zhaowei0566/mAEWing1/Design/FEM/FEM v5.2/Matlab files/README.txt

v2 has some changes in the nodal coordinates for control flaps in inner wing body flap and outer wing trailing-edge control surfaces
Mode results and nodal coordinates along EA are same.
