zhaowei0566/mAEWing1/Design/CAD/mAEWing1 - Mass Properties.xlsx

Sheet: Skoll - Tracking
 |  |  | Position of Body CG (inch) |  |  | Inertia about Body CG (Kg-m^2)
 |  | Mass (g) | xCG | yCG | zCG | Ixx | Iyy | Izz | Notes
2015-06-06 | Airframe (CB1 + WS1) | 6269.81 | -23.73 | 0.00 | -0.49 | 3.098 | 0.528 | 3.315 | Summary Test Results
2015-06-06 | Removed Ballast | -109.34 | -4.62 | 0.00 | -0.90 | 0 | 0 | 0 | Assume negligible body inertia
 | Airframe | 6160.47 | -24.07 | 0.00 | -0.48 | 3.098 | 0.502 | 3.288
2015-06-06 | Removed Temporary Avionics Cover | -104.4 | -9.09 | 0.00 | -1.97 | 0.000318 | 0.0005964 | 0.0008816
 | Airframe | 6056.07 | -24.32 | 0.00 | -0.46 | 3.097 | 0.486 | 3.272
2015-06-11 | Added Collet + Yoke + Propeller | 47 | -33.99 | 0.00 | -1.24 | 0 | 0 | 0 | Assume negligible body inertia
 | Airframe | 6103.07 | -24.40 | 0.00 | -0.46 | 3.097 | 0.488 | 3.275
2015-06-11 | Added Avionics Cover | 58 | -9.09 | 0.00 | -1.97 | 0.0001766666667 | 0.0003313333333 | 0.0004897777778 | Scale Body Inertia from previous
 | Airframe | 6161.07 | -24.25 | 0.00 | -0.48 | 3.098 | 0.497 | 3.284
2015-06-15 | Added Ballast | 165 | -4.62 | 0.00 | -0.90 | 0 | 0 | 0 | Assume negligible body inertia
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
