zhaowei0566/mAEWing1/Design/CAD/mAEWing1 - BOM.xlsx

Sheet: Parts List
System | WBS | Type | Rev | Part Num | BOM Level | 1 | 2 | 3 | 4 | 5 | 6 | Part Name | Part Description | Qty | Material | Notes
mAE1 | 1000 | A | A | mAE1_A1000_A | 1 | X |  |  |  |  |  | Aircraft |  | 1 | N/A
mAE1 | 1050 | P | A | mAE1_P1050_A | 2 |  | X |  |  |  |  | body flap |  | 2 | E-glass / EPS 1.5#
mAE1 | 8001 | P | A | mAE1_P8001_A | 2 |  | X |  |  |  |  | Wing Attach Bushing | Bushing for #10-32 bolts in wing attach | 24 | ABS Plastic | Not depicted in CAD model
mAE1 | 2100 | A | A | mAE1_A2100_A | 2 |  | X |  |  |  |  | Centerbody Assembly |  | 1 | N/A
mAE1 | 2101 | P | A | mAE1_P2101_A | 3 |  |  | X |  |  |  | inboard rib |  | 2 | 1/8" Birch Ply
mAE1 | 2102 | P | A | mAE1_P2102_A | 3 |  |  | X |  |  |  | inboard keel attachment |  | 2 | 1/8" Birch Ply
mAE1 | 2103 | P | A | mAE1_P2103_A | 3 |  |  | X |  |  |  | left center body |  | 1 | E-glass / EPS 1.5#
mAE1 | 2104 | P | A | mAE1_P2104_A | 3 |  |  | X |  |  |  | right center body |  | 1 | E-glass / EPS 1.5#
mAE1 | 2105 | P | A | mAE1_P2105_A | 3 |  |  | X |  |  |  | center body attach |  | 2 | 1/4" carbon/foam panel
mAE1 | 2106 | P | A | mAE1_P2106_A | 3 |  |  | X |  |  |  | spar front top left |  | 1 | 0.4" Carbon/foam panel
mAE1 | 2107 | P | A | mAE1_P2107_A | 3 |  |  | X |  |  |  | spar rear left |  | 1 | 0.4" Carbon/foam panel
mAE1 | 2108 | P | A | mAE1_P2108_A | 3 |  |  | X |  |  |  | spar front bottom left |  | 1 | 0.4" Carbon/foam panel
mAE1 | 2109 | P | A | mAE1_P2109_A | 3 |  |  | X |  |  |  | spar front bottom right |  | 1 | 0.4" Carbon/foam panel
mAE1 | 2110 | P | A | mAE1_P2110_A | 3 |  |  | X |  |  |  | spar front top right |  | 1 | 0.4" Carbon/foam panel
mAE1 | 2111 | P | A | mAE1_P2111_A | 3 |  |  | X |  |  |  | spar rear right |  | 1 | 0.4" Carbon/foam panel
mAE1 | 2112 | P | A | mAE1_P2112_A | 3 |  |  | X |  |  |  | keel |  | 2 | 1/8" Birch Ply
mAE1 | 2113 | P | A | mAE1_P2113_A | 3 |  |  | X |  |  |  | tail hard point |  | 1 | 1/8" Birch Ply
mAE1 | 2150 | A | A | mAE1_A2150_A | 3 |  |  | X |  |  |  | motor mount assembly |  | 1 | N/A
mAE1 | 2151 | P | A | mAE1_P2151_A | 4 |  |  |  | X |  |  | motor mount |  | 1
mAE1 | 2152 | P | A | mAE1_P2152_A | 4 |  |  |  | X |  |  | motor mount cover |  | 1
dum |  |  |  | dum__ | 3 |  |  | X |  |  |  | motor - dummy |  | 1 | N/A | See Flight Systems
mAE1 | 2160 | A | A | mAE1_A2160_A | 3 |  |  | X |  |  |  | Airdata Assembly |  | 1 | N/A
mAE1 | 2161 | P | A | mAE1_P2161_A | 4 |  |  |  | X |  |  | airdata boom |  | 1 | Carbon tube
dum |  |  |  | dum__ | 4 |  |  |  | X |  |  | pitot-static probe - dummy |  | 1 | N/A | See Flight Systems
dum |  |  |  | dum__ | 3 |  |  | X |  |  |  | servo - dummy |  | 2 | N/A | See Flight Systems
dum |  |  |  | dum__ | 3 |  |  | X |  |  |  | servo tray - dummy |  | 2 | N/A | See Flight Systems
mAE1 | 2170 | P | A | mAE1_P2170_A | 3 |  |  | X |  |  |  | flight computer tray |  | 1 | 1/8" Birch Ply
dum |  |  |  | dum__ | 3 |  |  | X |  |  |  | flight computer - dummy |  | 1 | N/A | See Flight Systems
mAE1 | 2171 | P | A | mAE1_P2171_A | 3 |  |  | X |  |  |  | battery tray |  | 1 | 1/8" Birch Ply
dum |  |  |  | dum__ | 3 |  |  | X |  |  |  | Propulsion Battery - dummy |  | 1 | N/A | See Flight Systems
dum |  |  |  | dum__ | 3 |  |  | X |  |  |  | Avionics Battery - dummy |  | 1 | N/A | See Flight Systems
mAE1 | 2180 | A | A | mAE1_A2180_A | 3 |  |  | X |  |  |  | centerbody servo bracket assembly |  | 2 | N/A
mAE1 | 2181 | P | A | mAE1_P2181_A | 4 |  |  |  | X |  |  | servo bracket-servo attach |  | 1 | 1/8" Birch Ply
mAE1 | 2182 | P | A | mAE1_P2182_A | 4 |  |  |  | X |  |  | servo bracket-spar attach |  | 1 | 1/8" Birch Ply
dum |  |  |  | dum__ | 3 |  |  | X |  |  |  | servo - dummy | Futaba S9254, Use JR Servo Tray to mount | 2 | N/A | See Flight Systems
dum |  |  |  | dum__ | 3 |  |  | X |  |  |  | accel - dummy |  | 2 | N/A | See Flight Systems
mAE1 | 2191 | P | A | mAE1_P2191_A | 3 |  |  | X |  |  |  | camera lens mount | lens mount for mobius action cam lens | 1 | ABS
dum |  |  |  | dum__ | 3 |  |  | X |  |  |  | camera - dummy |  | 1 | N/A | See Flight Systems
dum |  |  |  | dum__ | 3 |  |  | X |  |  |  | camera imager and lens |  | 1 | N/A | See Flight Systems
mAE1 | 2200 | A | A | mAE1_A2200_A | 2 |  | X |  |  |  |  | Left Wing Assembly |  | 1 | N/A
mAE1 | 2210 | A | A | mAE1_A2210_A | 3 |  |  | X |  |  |  | wing spar |  | 1 | 0.4" Carbon/foam beam
mAE1 | 2211 | P | A | mAE1_P2211_A | 4 |  |  |  | X |  |  | wing spar foam |  | 1 | XPS Foam 2.3#
mAE1 | 2212 | P | A | mAE1_P2212_A | 4 |  |  |  | X |  |  | wing spar skin |  | 1 | Carbon [45,0,0]
mAE1 | 2213 | P | A | mAE1_P2213_A | 3 |  |  | X |  |  |  | top front left reinforcement |  | 1 | 0.4" Carbon/foam panel
mAE1 | 2214 | P | A | mAE1_P2214_A | 3 |  |  | X |  |  |  | top back left reinforcement |  | 1 | 0.4" Carbon/foam panel
mAE1 | 2215 | P | A | mAE1_P2215_A | 3 |  |  | X |  |  |  | bottom front left reinforcement |  | 1 | 0.4" Carbon/foam panel
mAE1 | 2216 | P | A | mAE1_P2216_A | 3 |  |  | X |  |  |  | bottom back left reinforcement |  | 1 | 0.4" Carbon/foam panel
mAE1 | 2220 | P | A | mAE1_P2220_A | 3 |  |  | X |  |  |  | left inboard wing |  | 1 | E-glass / EPS 1.5#
mAE1 | 2221 | P | A | mAE1_P2221_A | 3 |  |  | X |  |  |  | left outboard wing |  | 1 | E-glass / EPS 1.5#
mAE1 | 2222 | P | A | mAE1_P2222_A | 3 |  |  | X |  |  |  | left wing washout |  | 1 | E-glass / EPS 1.5#
mAE1 | 2230 | P | A | mAE1_P2230_A | 3 |  |  | X |  |  |  | wing attach rib |  | 1 | 1/4" carbon/foam panel
mAE1 | 2240 | P | A | mAE1_P2240_A | 3 |  |  | X |  |  |  | winglet attach |  | 1 | 1/4" carbon/foam panel
mAE1 | 2250 | P | A | mAE1_P2250_A | 3 |  |  | X |  |  |  | winglet |  | 1 | 1/4" carbon/foam panel
mAE1 | 2260 | P | A | mAE1_P2260_A | 3 |  |  | X |  |  |  | control surface |  | 3 | E-glass / EPS 1.5# | Make from Wing
dum |  |  |  | dum__ | 3 |  |  | X |  |  |  | servo - dummy | Futaba S9254, Use JR Servo Tray to mount | 3 | N/A | See Flight Systems
dum |  |  |  | dum__ | 3 |  |  | X |  |  |  | accel - dummy |  | 2 | N/A | See Flight Systems
mAE1 | 2300 | A | A | mAE1_A2300_A | 2 |  | X |  |  |  |  | Right Wing Assembly |  | 1 | N/A
mAE1 | 2310 | A | A | mAE1_A2310_A | 3 |  |  | X |  |  |  | wing spar |  | 1 | 0.4" Carbon/foam beam
mAE1 | 2311 | P | A | mAE1_P2311_A | 4 |  |  |  | X |  |  | wing spar foam |  | 1 | XPS Foam 2.3#
mAE1 | 2312 | P | A | mAE1_P2312_A | 4 |  |  |  | X |  |  | wing spar skin |  | 1 | Carbon [45,0,0]
mAE1 | 2313 | P | A | mAE1_P2313_A | 3 |  |  | X |  |  |  | top front right reinforcement |  | 1 | 0.4" Carbon/foam panel
mAE1 | 2314 | P | A | mAE1_P2314_A | 3 |  |  | X |  |  |  | top back right reinforcement |  | 1 | 0.4" Carbon/foam panel
mAE1 | 2315 | P | A | mAE1_P2315_A | 3 |  |  | X |  |  |  | bottom front right reinforcement |  | 1 | 0.4" Carbon/foam panel
mAE1 | 2316 | P | A | mAE1_P2316_A | 3 |  |  | X |  |  |  | bottom back right reinforcement |  | 1 | 0.4" Carbon/foam panel
mAE1 | 2320 | P | A | mAE1_P2320_A | 3 |  |  | X |  |  |  | right inboard wing |  | 1 | E-glass / EPS 1.5#
mAE1 | 2321 | P | A | mAE1_P2321_A | 3 |  |  | X |  |  |  | right outboard wing |  | 1 | E-glass / EPS 1.5#
mAE1 | 2322 | P | A | mAE1_P2322_A | 3 |  |  | X |  |  |  | right wing washout |  | 1 | E-glass / EPS 1.5#
mAE1 | 2330 | P | A | mAE1_P2330_A | 3 |  |  | X |  |  |  | wing attach rib |  | 1 | 1/4" carbon/foam panel
mAE1 | 2340 | P | A | mAE1_P2340_A | 3 |  |  | X |  |  |  | winglet attach |  | 1 | 1/4" carbon/foam panel
mAE1 | 2350 | P | A | mAE1_P2350_A | 3 |  |  | X |  |  |  | winglet |  | 1 | 1/4" carbon/foam panel
mAE1 | 2360 | P | A | mAE1_P2360_A | 3 |  |  | X |  |  |  | control surface |  | 3 | E-glass / EPS 1.5# | Make from Wing
dum |  |  |  | dum__ | 3 |  |  | X |  |  |  | servo - dummy | Futaba S9254, Use JR Servo Tray to mount | 3 | N/A | See Flight Systems
dum |  |  |  | dum__ | 3 |  |  | X |  |  |  | accel - dummy |  | 2 | N/A | See Flight Systems
Definitions
System | Aircraft Type designation (mAE1 - MiniMUTT Type, dum - dummy/COTS type, mAE2, xAE3)
WBS | Work Breakdown Structure Level
Type | Part Type (A-Assembly, P-Part, S-Standard, T-Tool)
Rev | Revision Level (new part = A)
Part Num | Generated Part Number
BOM Level | Hierarchy level
Part Name | Part Name
Part Description | Part Description
Qty | Quatity reuired to the next highest level
Material | Material Description
Notes | Part Notes

Sheet: Flight Systems and Standards
Category | System | Description | Manufacturer | Model | Qty | Unit | Notes | Cost - Unit ($) | Cost - Total ($) | Cost Quality | Weight - Unit (g) | Weight - Total (g) | Weight Quality | Size - Unit (xx) | Product Link | Avionics Bay | Battery Bay | Motor
Flight Systems | Flight Cntrl Comp | Flight Computer Assembly | UMN | Goldy | 1 | each |  | $2300.00 | $2300.00 | Estimated | 250 | 250 | Actual |  |  | 1
Flight Systems | Flight Cntrl Comp | Flight Computer | Phytec | 5200 Tiny | [1] | each |  | $140.00
Flight Systems | Flight Cntrl Comp | Daughterboard | UMN | UMN | [1] | each |  | $260.00
Flight Systems | Flight Cntrl Comp | IMU | Analog Devices | ADIS16405 | [1] | each |  | $800.00
Flight Systems | Flight Cntrl Comp | GPS Card | Hemisphere | Crescent | [1] | each |  | $300.00
Flight Systems | Flight Cntrl Comp | TM | FreeWave | MM2 900 MHz | [1] | each |  | $700.00
Flight Systems | Flight Cntrl Comp | RX Mux | AcroName | RX Mux | [1] | each |  | $80.00
Flight Systems | Flight Cntrl Comp | PWM | Arduino | Pro Mini | [1] | each |  | $20.00
Flight Systems | Flight Cntrl Comp | GPS Antenna | GPS Outfitters | Titan III | 1 | each | With shortened coax cable, removed cover | $59.99 | $59.99 | Actual | 60 | 60 | Actual | 2"L x 1.75W x 0.56"H | http://www.amazon.com/GPS-Outfitters-Titan-Universal-Antenna/dp/B0000ATIUG | 1
Flight Systems | Telemetry | TM Antennae |  |  | 1 | each |  | $5.00 | $5.00 | Estimated | 10 | 10 | Estimated |  |  | 1
Flight Systems | Telemetry | TM Coax Cable |  |  | 1 | each |  | $5.00 | $5.00 | Estimated | 3 | 3 | Estimated |  |  | 1
Flight Systems | RC Equipment | Receiver | Spektrum | AR8000 | 1 | each |  | $116.99 | $116.99 | Actual | 10 | 10 | Actual | 34.3 X 32.3 X 11.4 mm | http://www.horizonhobby.com/ar8000-8-channel-dsmx-receiver-spmar8000 | 1
Flight Systems | RC Equipment | Systems Battery | Turnigy | 800mAh 3S 1C Lipo Pack | 1 | each |  | $7.64 | $7.64 | Actual | 78 | 78 | Actual |  | http://www.hobbyking.com/hobbyking/store/__9173__Turnigy_800mAh_3S_20C_Lipo_Pack.html | 1
Flight Systems | RC Equipment | BEC | Castel Creations | CC BEC Pro | 2 | each | Modify with 18 Awg wire on output | $38.30 | $76.60 | Actual | 34 | 68 | Actual |  | http://www3.towerhobbies.com/cgi-bin/wti0001p?&I=LXYCA6&P=ML |  | 2
Flight Systems | Centerbody Actuation | Servo | Futaba | S9254 | 2 | each |  | $109.99 | $219.98 | Actual | 51 | 102 | Actual |  | http://www3.towerhobbies.com/cgi-bin/wti0001p?&I=LXFZP1
Flight Systems | Centerbody Actuation | Servo - Alternate | BK | DS-5001HV | 0 | each |  | $90.00 | $0.00 | Actual | 50 | 0 | Estimate |  | http://www.helidirect.com/bk-mini-cyclic-hv-servo-coreless-motor-speed-0-03s-torque-10-6kg-blue.html
Flight Systems | Centerbody Actuation | Servo - Alternate | Xpert | MM-3301-HV | 0 | each |  | $129.90 | $0.00 | Actual | 39 | 0 | Estimate |  | http://www.helidirect.com/xpert-mm-3301-hv-full-aluminum-mini-size-servo.html
Flight Systems | Centerbody Actuation | Servo Tray | JR | JRPA244 | 2 | each |  | $2.50 | $5.00 | Actual | 5 | 10 | Actual |  | http://www.horizonhobby.com/servo-tray-aileron-jrpa244
Flight Systems | Centerbody Actuation | Servo Arm | SECraft | SE0063 | 2 | each | Servo Arm 1" #4-40 | $15.00 | $30.00 | Actual | 1 | 2 | Estimate |  | http://www.espritmodel.com/aluminum-servo-arm-half-v3-futaba.aspx
Flight Systems | Centerbody Actuation | Servo Arm | SECraft | SWBFUTABA1 | 0 | each | Alternate - Servo Arm 1" #4-40 | $9.50 | $0.00 | Actual | 1 | 6 | Estimate |  | http://www.espritmodel.com/swb-doubleloc-servo-arms-futaba.aspx
Flight Systems | Centerbody Actuation | Servo Pushrod | SECraft | SE202 | 2 | each | 2.5" trunbuckle pushrod #4-40 | $3.75 | $7.50 | Actual | 0 | 0 | Estimate |  | http://www.espritmodel.com/pushrod-turnbuckle-aluminum-secraft-440-2.aspx
Flight Systems | Centerbody Actuation | Ball link | Dubro | DUB2318 | 4 | each | 12/pkg - 2 per surface | $2.33 | $9.33 | Actual | 0 | 0 | Estimate |  | http://www3.towerhobbies.com/cgi-bin/wti0001p?&I=LXJGU0
Flight Systems | Centerbody Actuation | Ball link - Alternate | SECraft | SC-BSBLV1-4-BK | 0 | each | 10/pkg - 1 per surface | $0.88 | $0.00 | Actual | 0 | 0 | Estimate |  | http://www.gator-rc.com/secraft-ball-link-4-40-qty-10
Flight Systems | Centerbody Actuation | Surface Horn | Robart | 326 5/16" ball link control horn | 4 | each | 2/pkg - 2 per surface | $1.84 | $7.38 | Actual | 1 | 4 | Estimate |  | http://www3.towerhobbies.com/cgi-bin/wti0001p?I=LXET41&P=FB&Q=1
Flight Systems | Centerbody Actuation | Surface Horn - Alternate | F3A Unlimited | FH5012 | 0 | each | 2/pkg - 1 per surface | $4.00 | $0.00 | Actual | 1 | 0 | Estimate |  | http://www.gator-rc.com/ball-bearing-clevis-w-flag-attachment-for-control-horn-2-pack-fh5013
Flight Systems | Centerbody Actuation | Hinges | Dubro | #257 - Nylon Hinge Heavy Duty w/cotter | 6 | each | 15/pkg - 3 per surface | $0.45 | $2.68 | Actual | 0 | 0 | Estimate |  | http://www3.towerhobbies.com/cgi-bin/wti0001p?&I=LXD944&P=M
Flight Systems | Wing Actuation | Servo | Futaba | S9254 | 6 | each |  | $109.99 | $659.94 | Actual | 51 | 306 | Actual |  | http://www3.towerhobbies.com/cgi-bin/wti0001p?&I=LXFZP1
Flight Systems | Wing Actuation | Servo - Alternate | BK | DS-5001HV | 0 | each |  | $90.00 | $0.00 | Actual | 50 | 0 | Estimate |  | http://www.helidirect.com/bk-mini-cyclic-hv-servo-coreless-motor-speed-0-03s-torque-10-6kg-blue.html
Flight Systems | Centerbody Actuation | Servo - Alternate | Xpert | MM-3301-HV | 0 | each |  | $129.90 | $0.00 | Actual | 39 | 0 | Estimate |  | http://www.helidirect.com/xpert-mm-3301-hv-full-aluminum-mini-size-servo.html
Flight Systems | Wing Actuation | Servo Tray | JR | JRPA244 | 6 | each |  | $2.50 | $15.00 | Actual | 5 | 30 | Actual |  | http://www.horizonhobby.com/servo-tray-aileron-jrpa244
Flight Systems | Wing Actuation | Servo Arm | SECraft | SE0063 | 6 | each | Servo Arm 1" #4-40 | $15.00 | $90.00 | Actual | 1 | 6 | Estimate |  | http://www.espritmodel.com/aluminum-servo-arm-half-v3-futaba.aspx
Flight Systems | Wing Actuation | Servo Arm | SECraft | SWBFUTABA1 | 0 | each | Alternate - Servo Arm 1" #4-40 | $9.50 | $0.00 | Actual | 1 | 6 | Estimate |  | http://www.espritmodel.com/swb-doubleloc-servo-arms-futaba.aspx
Flight Systems | Wing Actuation | Servo Pushrod | SECraft | SE202 | 6 | each | 2.5" trunbuckle pushrod #4-40 | $3.75 | $22.50 | Actual | 0 | 0 | Estimate |  | http://www.espritmodel.com/pushrod-turnbuckle-aluminum-secraft-440-2.aspx
Flight Systems | Wing Actuation | Ball link | Dubro | DUB2318 | 12 | each | 12/pkg - 2 per surface | $2.33 | $28.00 | Actual | 0 | 0 | Estimate |  | http://www3.towerhobbies.com/cgi-bin/wti0001p?&I=LXJGU0
Flight Systems | Centerbody Actuation | Ball link - Alternate | SECraft | SC-BSBLV1-4-BK | 0 | each | 10/pkg - 1 per surface | $0.88 | $0.00 | Actual | 0 | 0 | Estimate |  | http://www.gator-rc.com/secraft-ball-link-4-40-qty-10
Flight Systems | Wing Actuation | Surface Horn | Robart | 326 5/16" ball link control horn | 12 | each | 2/pkg - 2 per surface | $1.84 | $22.14 | Actual | 1 | 12 | Estimate |  | http://www3.towerhobbies.com/cgi-bin/wti0001p?I=LXET41&P=FB&Q=1
Flight Systems | Wing Actuation | Surface Horn - Alternate | F3A Unlimited | FH5012 | 0 | each | 2/pkg - 1 per surface | $4.00 | $0.00 | Actual | 1 | 0 | Estimate |  | http://www.gator-rc.com/ball-bearing-clevis-w-flag-attachment-for-control-horn-2-pack-fh5013
Flight Systems | Wing Actuation | Hinges | Dubro | #117- Nylon Hinge Standard | 18 | each | 15/pkg - 3 per surface | $0.33 | $5.99 | Actual | 0 | 0 | Estimate |  | http://www3.towerhobbies.com/cgi-bin/wti0001p?&I=LXD941&P=ML
Flight Systems | Wing Actuation | Servo Reverser | Expert | EXRA320 | 1 | each | Comes with Y-Harness, remove | $8.50 | $8.50 | Actual | 10 | 10 | Estimate |  | http://www.horizonhobby.com/y-harness-6-inch-reverser-standard-exra320
Flight Systems | Propulsion System | Motor | E-Flite | Power 52 | 1 | each |  | $109.99 | $109.99 | Actual | 357 | 357 | Actual |  | http://www.horizonhobby.com/airplanes/motors/power-52-brushless-outrunner-motor--590kv-eflm4052a |  |  | 1
Flight Systems | Propulsion System | Speed Control | Castle Creation | Phoenix Edge Lite 75 | 1 | each |  | $102.00 | $102.00 | Actual | 85 | 85 | Actual |  | http://www.horizonhobby.com/phoenix-edge-lite-75--34v-75-amp-esc-w--5-amp-bec-cse010011200 |  |  | 1
Flight Systems | Propulsion System | Propulsion Battery | Thunder Power | TP3300-3SPP45 | 2 | each | 3300mAh 3-Cell | $69.00 | $138.00 | Actual | 273.32 | 546.64 | Actual |  |  |  | 2
Flight Systems | Propulsion System | Propeller | HK | HKCF1210 | 0 | each | Alternate Prop - Folding 12" X 10" | $35.00 | $0.00 | Actual | 13 | 0 | Actual |  | http://www.espritmodel.com/hk-carbon-fiber-folding-propellers.aspx |  |  | 0
Flight Systems | Propulsion System | Propeller | Aeronaut | AER7234/49 | 1 | each | Folding 12" X 10" | $13.00 | $13.00 | Actual | 16 | 16 | Actual |  | http://www.espritmodel.com/aeronaut-cam-folding-propellers-rudi-freudenthaler.aspx |  |  | 1
Flight Systems | Propulsion System | Propeller Yoke | Aeronaut | AER724221 | 1 | each | Yoke for folding prop, 38mm pin-to-pin, 8mm shoulder | $9.00 | $9.00 | Actual | 8 | 8 | Actual |  | http://www.espritmodel.com/aeronaut-yoke-for-turbo-and-black-spinners.aspx |  |  | 1
Flight Systems | Propulsion System | Propeller Adaptor | Great Planes | ElectriFly GPMQ4968 | 1 | each | 6mm shaft collet adaptor | $5.49 | $5.49 | Actual | 23 | 23 | Actual |  | http://www3.towerhobbies.com/cgi-bin/wti0001p?&I=LXMTB3&P=M |  |  | 1
Flight Systems | ADC/Accelerometer System | ADC Breakout | ProtoAdvantage | PA0060 w/SX8724CWLTDTCT-ND | 2 | each | Price is assembled, Weight is with filter assembly | $21.73 | $43.46 | Actual | 8 | 16 | Actual |  | http://www.proto-advantage.com/store/product_info.php?products_id=2250064 | 2
Flight Systems | ADC/Accelerometer System | ADC | Semtech | SX8724C | [2] | each | Need 6 channels for the accelerometers SX8724C has 3 differential channels each | N/A | N/A | N/A | N/A | N/A | N/A | N/A
Flight Systems | ADC/Accelerometer System | Accelerometer Isolation Cap |  | 0.1 uF | 2 | each | Digikey PN 1109PHCT-ND | $0.38 | $0.76 | Actual | N/A | N/A | N/A | N/A | http://www.digikey.com/product-detail/en/A104K15X7RF5TAA/1109PHCT-ND/145913 | 2
Flight Systems | ADC/Accelerometer System | Accelerometer Breakout | ProtoAdvantage | PA0006 w/MMA22XX | 2 | each | Price is assembled, Weight is for assembled with filter | $20.63 | $41.26 | Actual | 2.8 | 5.666666667 | Actual |  | http://www.proto-advantage.com/store/product_info.php?products_id=2200006 | 1 | 1
Flight Systems | ADC/Accelerometer System | Accelerometer Part | Freescale | MMA2240KEG | [2] | each | Order assembled on breakout | N/A | N/A | N/A | N/A | N/A | N/A | N/A
Flight Systems | ADC/Accelerometer System | Accelerometer Filter Resistor |  | 47 kohm | 2 | each | Digikey PN RNF14FTD47K0CT-ND | $0.37 | $0.74 | Actual | N/A | N/A | N/A | N/A | http://www.digikey.com/product-detail/en/RNF14FTD47K0/RNF14FTD47K0CT-ND/1975140 | 2
Flight Systems | ADC/Accelerometer System | Accelerometer Filter Cap |  | 0.22 uF | 2 | each | Digikey PN 1227PHCT-ND | $0.59 | $1.18 | Actual | N/A | N/A | N/A | N/A | http://www.digikey.com/product-detail/en/A224K20X7RF5TAA/1227PHCT-ND/2356863 | 2
Flight Systems | ADC/Accelerometer System | Accelerometer Voltage Divider Resistor |  | 47 kohm | 4 | each | Digikey PN RNF14FTD47K0CT-ND | $0.37 | $1.48 | Actual | N/A | N/A | N/A | N/A | http://www.digikey.com/product-detail/en/RNF14FTD47K0/RNF14FTD47K0CT-ND/1975140 | 4
Flight Systems | ADC/Accelerometer System | Accelerometer Breakout | ProtoAdvantage | PA0006 w/MMA22XX | 4 | each | Price is assembled, Weight is for assembled with filter | $20.63 | $82.52 | Actual | 2.8 | 11.33333333 | Actual |  | http://www.proto-advantage.com/store/product_info.php?products_id=2200006
Flight Systems | ADC/Accelerometer System | Accelerometer Part | Freescale | MMA2240KEG | [4] | each | Order assembled on breakout | N/A | N/A | N/A | N/A | N/A | N/A | N/A
Flight Systems | ADC/Accelerometer System | Accelerometer Filter Resistor |  | 47 kohm | 4 | each | Digikey PN RNF14FTD47K0CT-ND | $0.37 | $1.48 | Actual | N/A | N/A | N/A | N/A | http://www.digikey.com/product-detail/en/RNF14FTD47K0/RNF14FTD47K0CT-ND/1975140 | 4
Flight Systems | ADC/Accelerometer System | Accelerometer Filter Cap |  | 0.22 uF | 4 | each | Digikey PN 1227PHCT-ND | $0.59 | $2.36 | Actual | N/A | N/A | N/A | N/A | http://www.digikey.com/product-detail/en/A224K20X7RF5TAA/1227PHCT-ND/2356863 | 4
Flight Systems | ADC/Accelerometer System | Accelerometer Voltage Divider Resistor |  | 47 kohm | 8 | each | Digikey PN RNF14FTD47K0CT-ND | $0.37 | $2.96 | Actual | N/A | N/A | N/A | N/A | http://www.digikey.com/product-detail/en/RNF14FTD47K0/RNF14FTD47K0CT-ND/1975140 | 8
Flight Systems | Airdata | Airdata Probe | Eagle Tree | Prandtl Pitot Tube Kit | 1 | each | Probe comes with tubes | $8.49 | $8.49 | Actual | 3 | 3 | Actual | 80 X 4 X 4 mm | http://www3.towerhobbies.com/cgi-bin/wti0001p?&I=LXWGR1 | 1
Flight Systems | Airdata | Airdata Boom |  | Generic Carbon Tube | 1 | each | Carbon Tube | $5.00 | $5.00 | Estimated | 15 | 15 | Estimate |  |  | 1
Flight Systems | Airdata | Pressure Sensors - Absolute | AMSYS | AMS 5812-0150-B | 1 | each | Static Pressure | $25.20 | $25.20 | Actual | 3 | 3 | Actual |  | http://www.servoflo.com/ | 1
Flight Systems | Airdata | Pressure Sensors | AMSYS | AMS 5812-0003-D | 1 | each | Pitot Pressure | $29.92 | $29.92 | Actual | 3 | 3 | Actual |  | http://www.servoflo.com/ | 1
Flight Systems | Video System | Camera | Mobeius | ActionCam | 1 | each | With shielding and SD card | $122.95 | $122.95 | Actual | 38 | 38 | Actual |  | https://www.mobius-actioncam.com/store/products/mobius-basic-actioncam-16g-2/ |  | 1
Flight Systems | Video System | Camera Lens Extension Cable | Mobeius | 8 Inch Lens Extension Cable | 1 | each | Extension cable for imager board and lens | $14.95 | $14.95 | Actual | 5 | 5 | Estimate |  | https://www.mobius-actioncam.com/store/products/mobius-8-inch-lens-extension-cable/ |  | 1
Flight Systems | Video System | Lens | Gino | 8mm lens | 1 | each | Generic S-mount 8mm lens | $4.58 | $4.58 | Actual | 5 | 5 | Actual |  | http://www.amazon.com/gp/product/B00N3ZOSWU |  | 1
Flight Systems | Video System | Video Tx | FatShark | FS-2463 | 0 | each | 250mW 5.8 GHz A/V Transmitter | $64.99 | $0.00 | Actual | 23 | 0 | SpecSheet |  | http://www.amazon.com/FatShark-250mW-5-8GHz-Transmitter-NexwaveRF/dp/B00KB3S5YO |  | 0
Fasteners | Winglet Attach Fastener | Winglet Attach Blind Nut / T-Nut |  | #4-40 Blind nut | 4 | each | Winglet mounting, flatten spurs and bond to carbon panel | $0.26 | $1.04 | Actual | 0 | 0 | Estimate |  | http://www3.towerhobbies.com/cgi-bin/wti0001p?&I=LXD968&P=7
Fasteners | Winglet Attach Fastener | Winglet Attach Machine Screw |  | #4-40 Nylon 1" | 4 | each | Winglet mounting | $0.13 | $0.53 | Actual | 0 | 0 | Estimate |  | https://www.fastenal.com/products/details/0181940
Fasteners | Wing Attach Fastener | Wing Attach Bolt |  | #10-32 Stainless Steel 3/4" | 12 | each |  | $0.21 | $2.52 | Actual | 3 | 36 | Estimate |  | https://www.fastenal.com/products/details/73745
Fasteners | Wing Attach Fastener | Wing Attach Nut |  | #10-32 Stainless Steel | 12 | each |  | $0.06 | $0.72 | Actual | 1.5 | 18 | Estimate |  | https://www.fastenal.com/products/details/70708
Fasteners | Keel Attach Fastener | Keel Attach Bolt |  | 1/4"-20 Stainless Steel 3/4" | 2 | each |  | $0.32 | $0.64 | Actual | 5 | 10 | Estimate |  | https://www.fastenal.com/products/details/70003
Fasteners | Keel Attach Fastener | Keel Attach Nut |  | 1/4"-20 Stainless Steel | 2 | each |  | $0.12 | $0.24 | Actual | 3 | 6 | Estimate |  | https://www.fastenal.com/products/details/70710
Fasteners | Motor Mount Attach Fastener | Motor Mount Bolt |  | 1/4"-20 Stainless Steel 3/4" | 2 | each |  | $0.32 | $0.64 | Actual | 5 | 10 | Estimate |  | https://www.fastenal.com/products/details/70003
Fasteners | Motor Mount Attach Fastener | Motor Mount Nut Insert |  | 1/4"-20 Steel Insert | 2 | each |  | $0.34 | $0.68 | Actual | 2 | 4 | Estimate |  | https://www.fastenal.com/products/details/11138962
Fasteners | Avionic Tray Fastener | Avionics Tray Blind Nut / T-Nut |  | #4-40 Blind nut | 8 | each | 4 to mount the tray to Goldy, 4 embedded as hard points | $0.26 | $2.08 | Actual | 0 | 0 | Estimate |  | http://www3.towerhobbies.com/cgi-bin/wti0001p?&I=LXD968&P=7
Fasteners | Avionic Tray Fastener | Avionics Tray Machine Screw |  | #4-40 Stainless Steel 1/4" Flush | 4 | each | common to Goldy | $0.05 | $0.20 | Actual | 0 | 0 | Estimate |  | https://www.fastenal.com/products/details/0173843
Fasteners | Avionic Tray Fastener | Avionics Tray Machine Screw |  | #4-40 3/8" Socket head | 4 | each | common to hardpoints | $0.06 | $0.24 | Actual |  | 0 | Estimate |  | https://www.fastenal.com/products/details/73411
Fasteners | Avionic Tray Fastener | Avionics Tray Wood Screw |  |  | 2 | each |  | $0.05 | $0.10 | Estimate |  | 0 | Estimate
Fasteners | Battery Tray Fastener | Battery Tray Wood Screw |  |  | 2 | each |  | $0.05 | $0.10 | Estimate |  | 0 | Estimate
Wiring/Connect | Power Wiring/Connect | Power Wire - Red | CNC Tech | 18 awg Silicon - Red | 6 | ft |  | $0.95 | $5.67 | Actual | 3 | 18 | Estimated |  | http://www.digikey.com/product-search/en?x=0&y=0&lang=en&site=us&keywords=CN101R-25-ND |  | 6
Wiring/Connect | Power Wiring/Connect | Power Wire - Black | CNC Tech | 18 awg Silicon - Black | 6 | ft |  | $0.95 | $5.67 | Actual | 3 | 18 | Estimated |  | http://www.digikey.com/product-search/en?x=0&y=0&lang=en&site=us&keywords=CN101B-25-ND |  | 6
Wiring/Connect | Servo Wiring/Connect | Servo Wire | HiTec | 24 AWG servo wire 3 conductor | 20 | feet | Length roughly estimated, assumed twisted | $0.31 | $6.16 | Actual | 3 | 60 | Estimated |  | http://www3.towerhobbies.com/cgi-bin/wti0001p?&I=LXN661
Wiring/Connect | Signal Wiring/Connect | Signal Wire | Remington Industries | 24 awg (UL 1007) | 64 | ft |  | $0.13 | $8.11 | Actual | 1 | 64 | Estimated |  | http://www.amazon.com/s/ref=nb_sb_noss?url=search-alias%3Daps&field-keywords=B00N51OJNK
Wiring/Connect | Servo Wiring/Connect | Servo Male Connector |  | Futaba J connector Housing | 8 | each | Housing | $0.20 | $1.60 | Actual | 1 | 8 | Estimated |  | http://hobbyking.com/hobbyking/store/__43715__JST_SH_Servo_Plug_Set_Futaba_Gold_Plated_10pairs_set_US_Warehouse_.html | 2 | 2
Wiring/Connect | Servo Wiring/Connect | Servo Female Connector - Housing |  | Futaba J connector Housing | 8 | each | Housing | $0.20 | $1.60 | Actual | 1 | 8 | Estimated |  | http://hobbyking.com/hobbyking/store/__43715__JST_SH_Servo_Plug_Set_Futaba_Gold_Plated_10pairs_set_US_Warehouse_.html | 2 | 2
Wiring/Connect | Servo Wiring/Connect | Servo Female Connector - Sleeve |  | Futaba J connector Sleeve | 8 | each | Sleeve | $0.20 | $1.60 | Actual | 1 | 8 | Estimated |  | http://hobbyking.com/hobbyking/store/__43715__JST_SH_Servo_Plug_Set_Futaba_Gold_Plated_10pairs_set_US_Warehouse_.html | 2 | 2
Wiring/Connect | Servo Wiring/Connect | Servo Male Terminal |  | Male Terminals | 24 | each |  | $0.10 | $2.40 | Actual | 0 | 0 | Estimated |  | http://hobbyking.com/hobbyking/store/__43715__JST_SH_Servo_Plug_Set_Futaba_Gold_Plated_10pairs_set_US_Warehouse_.html | 6 | 6
Wiring/Connect | Servo Wiring/Connect | Servo Female Terminal |  | Female Terminals | 24 | each |  | $0.10 | $2.40 | Actual | 0 | 0 | Estimated |  | http://hobbyking.com/hobbyking/store/__43715__JST_SH_Servo_Plug_Set_Futaba_Gold_Plated_10pairs_set_US_Warehouse_.html | 6 | 6
Wiring/Connect | Power Wiring/Connect | ESC Connector | Deans | Ultra - Male | 4 | each |  | $1.59 | $6.38 | Actual | 3 | 12 | Estimated |  | http://www3.towerhobbies.com/cgi-bin/wti0001p?&I=LXHGL9&P=M |  | 4
Wiring/Connect | Power Wiring/Connect | ESC Connector | Deans | Ultra - Female | 2 | each |  | $1.59 | $3.19 | Actual | 3 | 6 | Estimated |  | http://www3.towerhobbies.com/cgi-bin/wti0001p?&I=LXGDU8&P=M |  | 2
Wiring/Connect | Power Wiring/Connect | Power Connector | JST | RCY Series - Male Housing | 6 | each |  | $0.19 | $1.14 | Actual | 1 | 6 | Estimated |  | http://www.digikey.com/product-detail/en/SYP-02T-1/455-2654-ND/2206861 | 3 | 3
Wiring/Connect | Power Wiring/Connect | Power Connector | JST | RCY Series - Male Housing Connector (Female) | 12 | each |  | $0.11 | $1.32 | Actual | 1 | 12 | Estimated |  | http://www.digikey.com/product-detail/en/SYF-001T-P0.6(LF)(SN)/455-2652-1-ND/2796952 | 6 | 6
Wiring/Connect | Power Wiring/Connect | Power Connector | JST | RCY Series - Female Housing | 6 | each |  | $0.22 | $1.32 | Actual | 1 | 6 | Estimated |  | http://www.digikey.com/product-detail/en/SYR-02T/455-2653-ND/2409499 | 3 | 3
Wiring/Connect | Power Wiring/Connect | Power Connector | JST | RCY Series - Female Housing Connector (Male) | 12 | each |  | $0.11 | $1.32 | Actual | 1 | 12 | Estimated |  | http://www.digikey.com/product-detail/en/SYM-001T-P0.6(N)/455-1909-1-ND/1465028 | 6 | 6
Wiring/Connect | Signal Wiring/Connect | Plug | Molex | Mini-Fit JR - WM3606-ND | 2 | each |  | $0.68 | $1.36 | Actual | 2 | 4 | Estimated |  | http://www.digikey.com/product-detail/en/39-01-2141/WM3606-ND/61288
Wiring/Connect | Signal Wiring/Connect | Contact - Male | Molex | Mini-Fit JR - WM2500CT-ND | 26 | each |  | $0.10 | $2.60 | Actual | 0 | 0 | Estimated |  | http://www.digikey.com/product-detail/en/0039000040/WM2500CT-ND/467979
Wiring/Connect | Signal Wiring/Connect | Receptacle | Molex | Mini-Fit JR - WM3706-ND | 2 | each |  | $0.75 | $1.50 | Actual | 2 | 4 | Estimated |  | http://www.digikey.com/product-detail/en/0039012140/WM3706-ND/61391
Wiring/Connect | Signal Wiring/Connect | Contact - Female | Molex | Mini-Fit JR - WM2501CT-ND | 26 | each |  | $0.10 | $2.60 | Actual | 0 | 0 | Estimated |  | http://www.digikey.com/product-detail/en/0039000038/WM2501CT-ND/467978
Wiring/Connect | Signal Wiring/Connect | Housing - 4 position | TE Connectivity | CST-100 II - 1375820-4 | 8 | each |  | $0.15 | $1.20 | Actual | 1 | 8 | Estimated |  | http://www.digikey.com/product-detail/en/1375820-4/A99615-ND/634994 | 8
Wiring/Connect | Signal Wiring/Connect | Header - 4 position | TE Connectivity | CST-100 II - 640456-4 | 5 | each |  | $0.15 | $0.75 | Actual | 0 | 0 | Estimated |  | http://www.digikey.com/product-detail/en/640456-4/A1922-ND/109006 | 5
Wiring/Connect | Signal Wiring/Connect | Housing - 6 position | TE Connectivity | CST-100 II - 1375820-6 | 4 | each |  | $0.25 | $1.00 | Actual | 1 | 4 | Estimated |  | http://www.digikey.com/product-detail/en/1375820-6/A99617-ND/1864918 | 4
Wiring/Connect | Signal Wiring/Connect | Header - 6 position | TE Connectivity | CST-100 II - 640456-6 | 4 | each |  | $0.20 | $0.80 | Actual | 0 | 0 | Estimated |  | http://www.digikey.com/product-detail/en/640456-6/A1923-ND/109008 | 4
Wiring/Connect | Signal Wiring/Connect | Crimp Pin Connector - Female | TE Connectivity | CST-100 II - 1375819-1 | 56 | each |  | $0.05 | $2.80 | Actual | 0 | 0 | Estimated |  | http://www.digikey.com/product-detail/en/1375819-1/A100453CT-ND/2233146 | 56
Wiring/Connect | Signal Wiring/Connect | Ethernet Socket |  |  | 1 | each |  | $0.50 | $0.50 | Estimate | 3 | 3 | Estimated |  |  | 1
Wiring/Connect | Signal Wiring/Connect | Data Dump Switch |  |  | 1 | each |  | $0.50 | $0.50 | Estimate | 1 | 1 | Estimated |  |  | 1
Wiring/Connect | Signal Wiring/Connect | 50-pin Connector |  | Mates with Goldy | 1 | each |  | $0.50 | $0.50 | Estimate | 2 | 2 | Estimated |  |  | 1
Wiring/Connect | Signal Wiring/Connect | 15 pin Output Port |  | Mates with Goldy | 1 | each |  | $0.50 | $0.50 | Estimate | 1 | 1 | Estimated |  |  | 1
Wiring/Connect | Signal Wiring/Connect | 15 pin Input Port |  | Mates with Goldy | 1 | each |  | $0.50 | $0.50 | Estimate | 1 | 1 | Estimated |  |  | 1
 |  |  |  |  |  |  |  |  | Total |  |  | Total |  |  |  | Total | Total | Total
 |  |  |  |  |  |  |  |  | $4548.64 |  |  | 2463.6 |  |  |  | 497.8 | 743.5 | 489.0

Sheet: Materials Consumables
Description | Manufacturer | Model | Qty | Units | Notes | Cost - Unit ($) | Cost - Total ($) | Product Link
Spar Foam | Flying Foam | N/A | 2 | each | Surfboard XPS 2.3# | $15.00 | $30.00
Spar Fabric | Fiberglast | 530 | 3 | yard | Carbon 3K PW 5.7oz | $44.95 | $134.85 | http://www.fibreglast.com/product/3K_Plain_Weave_Carbon_Fiber_Fabric_00530/carbon_fiber_all
Wing Form Foam | Flying Foam | N/A | 1 | each | EPS 1.5# (Left and Right Shipset) | $200.00 | $200.00
Wing Cover Fabric | Fiberglast | 543 | 6 | yard | 7781 Style - 9.0oz E-Glass Satin Weave (7.5oz E-glass used on WS1) | $9.25 | $55.50 | http://www.fibreglast.com/product/Style_7781_E_Glass_543/Fiberglass_Fabric
Wing Reinforce Fabric | Fiberglast | 530 | 1 | yard | Carbon 3K PW 5.7oz | $44.95 | $44.95 | http://www.fibreglast.com/product/3K_Plain_Weave_Carbon_Fiber_Fabric_00530/carbon_fiber_all
Carbon Panel for ribs and winglets | ACP Sales | LP-NH250-CFPW1-6 | 1 | each | Budgetary estimate only, additional $200 for waterjet | $158.50 | $158.50 | http://www.acpsales.com/Carbon-Fiber-1-Ply-Honeycomb.html
Plywood | Aircraft Spruce |  | 1 | each |  | $48.00 | $48.00
Balsa |  |  | 1 | each | Cut strips 3/4" X 3/16" for hinge line, purchase as package of sheets | $10.99 | $10.99 | http://www3.towerhobbies.com/cgi-bin/wti0001p?&I=LXJC92&P=ML
Centerbody Foam Form |  |  | 1 | each | EPS 1.5# (Left and Right Side) | $575.00 | $575.00
Centerbody Cover Fabric | Fiberglast | 543 | 3 | yard | 7781 Style - 9.0oz E-Glass Satin Weave | $9.25 | $27.75 | http://www.fibreglast.com/product/Style_7781_E_Glass_543/Fiberglass_Fabric
Centerbody Reinforce Fabric | Fiberglast | 530 | 1 | yard | Carbon 3K PW 5.7oz | $44.95 | $44.95 | http://www.fibreglast.com/product/3K_Plain_Weave_Carbon_Fiber_Fabric_00530/carbon_fiber_all
Vacuum Bag Composite System
Epoxy | Fiberglast | 2000 | 1 | gallon |  | $104.95 | $104.95 | http://www.fibreglast.com/product/System_2000_Epoxy_Resin_2000/Epoxy_Resins
Epoxy Hardener | Fiberglast | 2060 | 1 | quart |  | $44.95 | $44.95 | http://www.fibreglast.com/product/2060_Epoxy_Hardener_2060
Release Film | Fiberglast | 1781 | 10 | yard |  | $2.95 | $29.50 | http://www.fibreglast.com/product/low-temperature-release-film-1580/Vacuum_Bagging_Films_Peel_Ply_Tapes
Nylon Release Peel Ply (Release Film Alternate) | Fiberglast | 582 | 0 | yard | Use for bonded surfaces | $10.75 | $0.00 | http://www.fibreglast.com/product/Nylon_Released_Peel_Ply_582/Vacuum_Bagging_Films_Peel_Ply_Tapes
Breather Cloth | Fiberglast | 579 | 10 | yard |  | $4.75 | $47.50 | http://www.fibreglast.com/product/Breather_and_Bleeder_579
Vacuum Bag | Fiberglast | 1678 | 10 | yard |  | $3.90 | $39.00 | http://www.fibreglast.com/product/stretchlon-200-bagging-film-1678/Vacuum_Bagging_Films_Peel_Ply_Tapes
Flash Tape | Fiberglast | 584 | 1 | each | 70 yd roll | $29.95 | $29.95 | http://www.fibreglast.com/product/flash-tape-00584/Vacuum_Bagging_Films_Peel_Ply_Tapes
Tacky Tape | Fiberglast | 581 | 5 | each | 25' Rolls | $7.95 | $39.75 | http://www.fibreglast.com/product/gray-sealant-tape-00581/Vacuum_Bagging_Films_Peel_Ply_Tapes
Brushes, misc supplies |  |  | 1 | each | Budgetary estimate only | $300.00 | $300.00
Spar Cure Tools |  | 72" X 4" X 3/8" Aluminum plate 6061 | 1 | each | Top Caul | $46.25 | $46.25
Spar Cure Tools |  | 72" X 1" X 3/8" Aluminum bar 6061 | 2 | each | Side Cauls | $11.56 | $23.12
 |  |  |  |  |  |  | Total
 |  |  |  |  |  |  | $2035.46

Sheet: Ground Support Equip
Description | Manufacturer | Model | Qty | Notes | Cost - Unit ($) | Cost - Total ($) | Product Link
Ground Control Station
Ground Station Transmitter | FreeWave | FGR2-CE-U | 1 |  | $1300.00 | $1300.00
Ground Station Battery | Turnigy | 2650mAh 3S 1C LLF Tx Pack | 3 |  | $13.00 | $39.00
Serial Express Card | SyncroTech | EXP34-RS232-02 | 1 |  | $37.00 | $37.00
USB to Serial Converter | Manhattan | Manhattan 205146 | 1 |  | $9.11 | $9.11
RC Equipment
Transmitter | Spektrum | DX9 | 1 |  | $399.99 | $399.99
LiPo Transmitter Battery | Spektrum | SPMB4000LPTX | 1 |  | $69.99 | $69.99
Video System
Video Rx
Video Screen | ReadyMadeRC | RMRC-LCD-10 | 1 | 10.1 inch LCD monitor | $153.99 | $153.99
Video Cables, etc | ReadyMadeRC |  | 1 |  | $40.00 | $40.00
Launcher System
PVC Tube |  | 10' 1.25" Sched 40 PVC | 3 |  | $3.00 | $9.00
PVC Connector Tee |  | PVC 3-way connector | 34 |  | $0.90 | $30.60
PVC Connector 4-way |  | PVC 4-way connector | 4 |  | $2.60 | $10.40 | http://www.amazon.com/FORMUFIT-F1144WT-WH-4-4-Way-Fitting-Furniture/dp/B00MNIYGSO
PVC Connector 5-way |  | PVC 5-way connector | 4 |  | $3.80 | $15.20 | http://www.amazon.com/FORMUFIT-F1145WC-WH-4-5-Way-Fitting-Furniture/dp/B00MNIYCHO
Quick Release Mechanism |  | Glider Tow Release | 1 |  | $3.29 | $3.29 | http://hobbyking.com/hobbyking/store/__32011__HobbyKing_Glider_Nose_Tow_Line_Release_11_7x42mm_US_Warehouse_.html
Rachet Straps |  |  | 2 |  |  | $0.00
Ground Testing
Inclinometer | AeroPerfect | MU-9000X | 1 |  | $219.00 | $219.00
Scales | American Weigh | Digital Scale | 3 | Mass Property Testing | $29.95 | $89.85
Hanging Scales | American Weigh | Hanging Scale | 2 | Mass Property Testing | $99.95 | $199.90
GVT Test Rig and Instrumentation
Chargers and Programmers
Castle Creations Castlelink | Castle Creations | 010-0005-00 | 1 |  | $24.95 | $24.95
Battery Charger | Thunder Power | TP610C-ACDC | 1 |  | $119.99 | $119.99
 |  |  |  |  |  | Total
 |  |  |  |  |  | $2771.26
