zhaowei0566/mAEWing1/Design/CAD/mAEWing1 - Configuration Tracking.xlsx

Sheet: Overview
MiniMUTT Class Aircraft - Current Configuration
Name | N-Number | Centerbody | Wing Set | Status
Fenrir |  | CB0 | WS0 | Storage
Sköll |  | CB1 | WS1 | Crashed FLT13
 |  |  | WS2
Hati |  | CB2 | WS3 | Crashed FLT03
Geri |  | CB3 | WS4
MiniMUTT Class Aircraft
Centerbody | Comments
CB0 | Proof of Concept MiniMUTT
CB1 | Sköll | Crashed Skoll FLT13
CB2 | Hati | Crashed Hati FLT03
CB3 | Geri
Wing Set | Comments
WS0 | Permanently mated to CB0 | Wing folded during last flight, unkown damage
WS1 | Sköll Stiff Wings | Left Wing Spar is Broken at Wing attach
WS2 | Hati Flexible Wings | Flyable Storage
WS3 | Hati Stiff Wings | Left Wing Spar is Broken at Wing attach
WS4 | Geri Stiff Wings

Sheet: CB0
Current Configuration
Flight Computer | Type | SN | Notes
Flight Computer Assembly | Goldy | 007
GPS Antenna | GPS Outfitters Titan III | 002
Receiver | Spektrum AR8000X
Body Flaps | Type | SN | Notes
Body Flap - Left | MiniMUTT v1.0 | 001
Body Flap - Right | MiniMUTT v1.0 | 002
Servos | Type | SN | Notes
L1 | Hitec HS-225BB | 007
R1 | Hitec HS-225BB | 008
Air Data | Type | SN | Notes
Pitot | AMS 5812-0003-D | 002 | Programmed for I2C address 0x02
Static | AMS 5812-0150-B | 002 | Programmed for I2C address 0x03
Probe | Eagle Tree V3 | 002
Power and Propulsion | Type | SN | Notes
Motor Mount Base | mAEWing1 v2.4 | 001
Motor Mount Cover | mAEWing1 v2.4 | 001
Motor | E-flite Power 46 | 001
ESC | Phoenix Edge Lite 75 | 001
Maintainance Tracking
Date | Action

Sheet: CB1
Current Configuration
Flight Computer / RC | Type | SN | Notes
Goldy |  | 007
Teensy 3.1 |  | 001
Voltage Divider / Filter |  | 001 | Custom. 5V to 3.33V. 35Hz 1st order LPF
Servo Reverser | Expert EXRA320 | 002
Body Flaps | Type | SN | Notes
Body Flap - Left | mAEWing1 v2.4 | 001
Body Flap - Right | mAEWing1 v2.4 | 002
Servos | Type | SN | Notes
L1 | Futaba S9254 | 014
R1 | Futaba S9254 | 015
Accelerometers | Type | SN | Notes
Forward | PA0006 w/MMA2240KEG | 005
Aft | PA0006 w/MMA2240KEG | 006
Air Data | Type | SN | Notes
Pitot | AMS 5812-0003-D | 002 | Programmed for I2C address 0x02
Static | AMS 5812-0150-B | 002 | Programmed for I2C address 0x03
Probe | Eagle Tree V3 | 003
Power and Propulsion | Type | SN | Notes
Motor Mount Base | mAEWing1 v2.4 | 002
Motor Mount Cover | mAEWing1 v2.4 | 002
Motor | E-flite Power 52 | 001
ESC | Phoenix Edge Lite 75 | 002
BEC - Left Side Power | CC BEC Pro | 001
BEC - Right Side Power | CC BEC Pro | 002
Camera | Type | SN | Notes
Camera Body | Mobius Action Cam | 001 | Firmware v2.37, Programmed: Video Mode 1 - 720-60fps, Video Mode 2 - 1080-30fps
Camera Imager | Mobius Action Cam | 001
Camera Lens | Gino 8mm | 001
Tracking
Date | Action
2015-06-06 | Installed Goldy SN 006 (removed SN 007)
2015-06-06 | Mass Property Test, added 110g ballast in nose
2015-06-09 | Removed temporary Avionics Cover
2015-06-09 | GVT Test (w/o avionics cover)
2015-06-11 | Installed Goldy SN 007 (removed SN 006)
2015-06-12 | Installed Avionics Cover (Orange)
2015-06-12 | Painted Orange on wing tops
2015-06-15 | Added Voltage Dividers on Accelerometer signals
2015-06-15 | Swapped bateries to use two "Thor" batteries in series
2015-06-24 | Replaced the Hemishere Cresecent with Novatel OEM Star
2015-06-24 | Moved GPS Antenna aft near the battery bay.
2015-06-29 | Replaced Pitot Probe, replaced tube with hole in static line, replaced airdata boom with shorter version.
2015-06-29 | Replaced Servo 007 with 009, 008 with 010.
2015-06-29 | Fixed Wing attach ribs (4x), added Kevlar strips to reinforce joints. Re-shimmed joints with balsa sheeting.
2015-07-06 | Repaired Centerbody nose
2015-08-01 | Removed Novatel OEMStar
2015-08-01 | Removed Titan III GPS antenna
2015-08-01 | Added a Teensy 3.1
2015-08-01 | Changed a whole bunch of wiring
2015-08-01 | Moved servo reverser from wing to centerbody
2015-08-01 | Repaired pitot probe, replaced dynamic pressure and static pressure transducer
2015-08-03 | Replaced Propellor
2015-08-09 | Replaced Propellor
2015-08-09 | Repaired wing attaches
2015-08-09 | Replaced 7 of 8 servos

Sheet: CB2
Current Configuration
Flight Computer / RC | Type | SN | Notes
Goldy |  | 007
Teensy 3.1 |  | 001
Voltage Divider / Filter |  | 002 | Custom. 5V to 3.33V. 35Hz 1st order LPF
Servo Reverser | Expert EXRA320 | 003 | Modified to be shorter
Body Flaps | Type | SN | Notes
Body Flap - Left | mAEWing1 v2.4 | 003
Body Flap - Right | mAEWing1 v2.4 | 004
Servos | Type | SN | Notes
L1 | Futaba S9254 | 022
R1 | Futaba S9254 | 023
Accelerometers | Type | SN | Notes
Forward | PA0006 w/MMA2240KEG | 011
Aft | PA0006 w/MMA2240KEG | 012
Air Data | Type | SN | Notes
Pitot | AMS 5812-0003-D | 003 | Programmed for I2C address 0x02
Static | AMS 5812-0150-B | 003 | Programmed for I2C address 0x03
Probe | Eagle Tree V3 | 005
Power and Propulsion | Type | SN | Notes
Motor Mount Base | mAEWing1 v2.4 | 001
Motor Mount Cover | mAEWing1 v2.4 | 001
Motor | E-flite Power 52 | 002
ESC | Phoenix Edge Lite 75 | 003
BEC - Left Side Power | CC BEC Pro | 003
BEC - Right Side Power | CC BEC Pro | 004
Camera | Type | SN | Notes
Camera Body | Mobius Action Cam | 001 | Firmware v2.37, Programmed: Video Mode 1 - 720-60fps, Video Mode 2 - 1080-30fps
Camera Imager | Mobius Action Cam | 001
Camera Lens | Gino 8mm | 001
Tracking
Date | Action
9/1/2015 | Mass Property Tested with WS2
9/24/2015 | Mass Property Tested with WS3
9/30/2015 | Replaced Pitot probe
 | Replaced DUBRO ball links with SECraft Brass ball links to eliminate sticking

Sheet: CB3
Current Configuration
Flight Computer / RC | Type | SN | Notes
Goldy |  | 007
Teensy 3.1 |  | 001
Voltage Divider / Filter |  | 002 | Custom. 5V to 3.33V. 35Hz 1st order LPF
Servo Reverser | Expert EXRA320 | 003 | Modified to be shorter
Body Flaps | Type | SN | Notes
Body Flap - Left | mAEWing1 v2.4 | 005
Body Flap - Right | mAEWing1 v2.4 | 006
Servos | Type | SN | Notes
L1 | Futaba S9254
R1 | Futaba S9254 | 005
Accelerometers | Type | SN | Notes
Forward | PA0006 w/MMA2240KEG | 017
Aft | PA0006 w/MMA2240KEG | 018
Air Data | Type | SN | Notes
Pitot | AMS 5812-0003-D | 003 | Programmed for I2C address 0x02
Static | AMS 5812-0150-B | 003 | Programmed for I2C address 0x03
Probe | Eagle Tree V3 | 006
Power and Propulsion | Type | SN | Notes
Motor Mount Base | mAEWing1 v2.4 | 002
Motor Mount Cover | mAEWing1 v2.4 | 002
Motor | E-flite Power 52 | 003
ESC | Phoenix Edge Lite 75 | 003
BEC - Left Side Power | CC BEC Pro | 003
BEC - Right Side Power | CC BEC Pro | 004
Camera | Type | SN | Notes
Camera Body | Mobius Action Cam | 001 | Firmware v2.37, Programmed: Video Mode 1 - 720-60fps, Video Mode 2 - 1080-30fps
Camera Imager | Mobius Action Cam | 001
Camera Lens | Gino 8mm | 001
Tracking
Date | Action
2016-07-27 | Mass Property Testing with WS4
2016-09-21 | Swapped ESC to SN003
2016-10-04 | Swapped Motor to SN003
2016-10-04 | Changed GPS from Ublox 7p to Ublox M8N

Sheet: WS0
Current Configuration
Left Side
Servos | Type | SN | Notes
L2 | Hitec HS-225BB | 001
L3 | Hitec HS-225BB | 002 | Polarity reversed via soldering
L4 | Hitec HS-225BB | 003
Winglet | Type | SN | Notes
Winglet | MiniMutt v1.0 | 001
Right Side
Servos | Type | SN | Notes
R2 | Hitec HS-225BB | 004
R3 | Hitec HS-225BB | 005
R4 | Hitec HS-225BB | 006
Winglet | Type | SN | Notes
Winglet | MiniMutt v1.0 | 002
Maintainance Tracking
Date | Action
 | Wing is severly damaged

Sheet: WS1
Current Configuration
Left Side
Servos | Type | SN | Notes
L2 | Futaba S9254 | 004
L3 | Futaba S9254 | 005
L4 | Futaba S9254 | 013
Accels | Type | SN | Notes
Forward | PA0006 w/MMA2240KEG | 001
Aft | PA0006 w/MMA2240KEG | 002
Winglet | Type | SN | Notes
Winglet | mAEWing1 v2.4 | 001
Right Side
Servos | Type | SN | Notes
R2 | Futaba S9254 | 002
R3 | Futaba S9254 | 011
R4 | Futaba S9254 | 012
Accels | Type | SN | Notes
Forward | PA0006 w/MMA2240KEG | 003
Aft | PA0006 w/MMA2240KEG | 004
Winglet | Type | SN | Notes
Winglet | mAEWing1 v2.4 | 002
Maintainance Tracking
Date | Action
2015-06-15 | Added Servo Reverser to L3, adjusted set point to zero
2015-06-29 | Fixed Wing attach ribs (4x), added Kevlar strips to reinforce joints. Re-shimmed joints with balsa sheeting.
2015-07-06 | Replaced Right Wing Servos (004, 005, 006) with (011, 012, 013)
2015-07-06 | Repaired Right Wing Inboard and Outboard Control Surface hinges
2015-07-06 | Repaired Left Outboard Wingtip
2015-08-01 | Moved servo reverser from wing to centerbody
 | Left Wing is severly damaged, no longer tracking changes

Sheet: WS2
Current Configuration
Left Side
Servos | Type | SN | Notes
L2 | Futaba S9254 | 016
L3 | Futaba S9254 | 017
L4 | Futaba S9254 | 018
Accels | Type | SN | Notes
Forward | PA0006 w/MMA2240KEG | 007
Aft | PA0006 w/MMA2240KEG | 008
Winglet | Type | SN | Notes
Winglet | mAEWing1 v2.4 | 003
Right Side
Servos | Type | SN | Notes
R2 | Futaba S9254 | 019
R3 | Futaba S9254 | 020
R4 | Futaba S9254 | 021
Accels | Type | SN | Notes
Forward | PA0006 w/MMA2240KEG | 009
Aft | PA0006 w/MMA2240KEG | 010
Winglet | Type | SN | Notes
Winglet | mAEWing1 v2.4 | 004
Maintainance Tracking
Date | Action
9/1/2015 | Mass Property Testing with CB2

Sheet: WS3
Current Configuration
Left Side
Servos | Type | SN | Notes
L2 | Futaba S9254
L3 | Futaba S9254
L4 | Futaba S9254
Accels | Type | SN | Notes
Forward | PA0006 w/MMA2240KEG | 013
Aft | PA0006 w/MMA2240KEG | 014
Winglet | Type | SN | Notes
Winglet | mAEWing1 v2.4 | 003
Right Side
Servos | Type | SN | Notes
R2 | Futaba S9254
R3 | Futaba S9254
R4 | Futaba S9254
Accels | Type | SN | Notes
Forward | PA0006 w/MMA2240KEG | 015
Aft | PA0006 w/MMA2240KEG | 016
Winglet | Type | SN | Notes
Winglet | mAEWing1 v2.4 | 004
Maintainance Tracking
Date | Action
9/29/2015 | Mass Property Testing with CB2
 | Replaced DUBRO ball links with SECraft Brass ball links to eliminate sticking

Sheet: WS4
Current Configuration
Left Side
Servos | Type | SN | Notes
L2 | Futaba S9254 | 002
L3 | Futaba S9254 | 001
L4 | Futaba S9254 | 004
Accels | Type | SN | Notes
Forward | PA0006 w/MMA2240KEG | 019
Aft | PA0006 w/MMA2240KEG | 020
Winglet | Type | SN | Notes
Winglet | mAEWing1 v2.4 | 003
Right Side
Servos | Type | SN | Notes
R2 | Futaba S9254 | 008
R3 | Futaba S9254 | 012
R4 | Futaba S9254 | 025
Accels | Type | SN | Notes
Forward | PA0006 w/MMA2240KEG | 021
Aft | PA0006 w/MMA2240KEG | 022
Winglet | Type | SN | Notes
Winglet | mAEWing1 v2.4 | 006
Maintainance Tracking
Date | Action
2016-07-27 | Mass Property Testing with CB3
