zhaowei0566/mAEWing1/Design/CAD/Center Body/flutter camera/flutter camera assembly.SLDASM

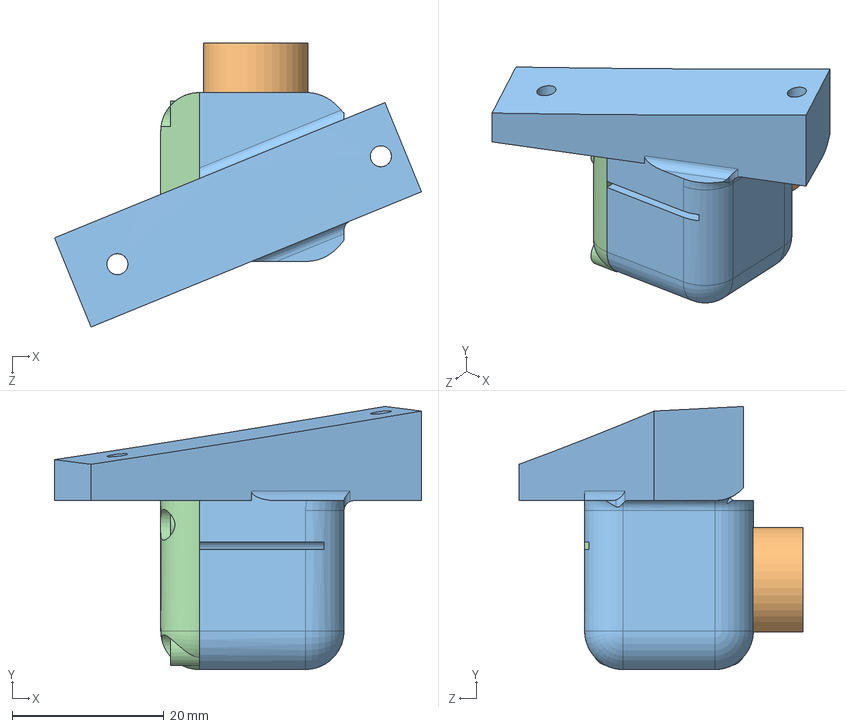
[picture p66: CAD file, 2015-07-17]
Design/CAD/Center Body/flutter camera/flutter camera assembly.SLDASM
48.3 x 34.6 x 37.4 mm
flutter camera back
flutter camera
flutter camera mount
flutter camera mount cover
