zhaowei0566/mAEWing1/Design/CAD/mAEWing1.SLDASM

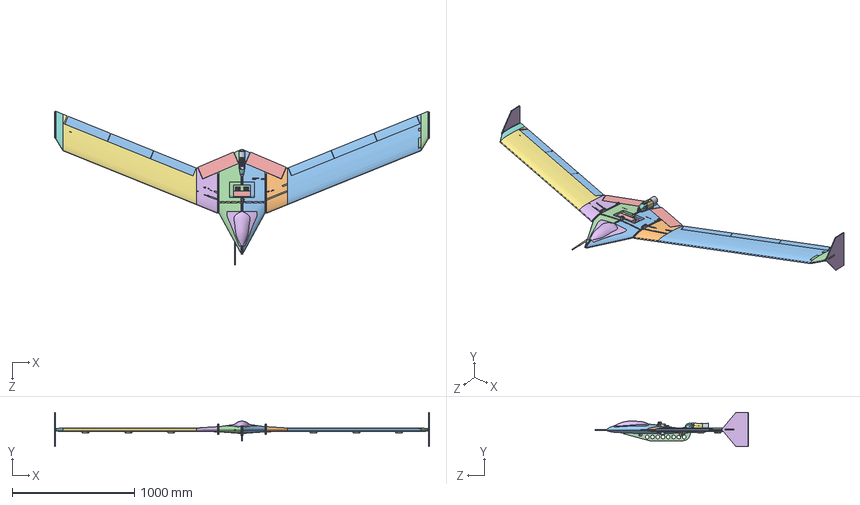
[picture p67: CAD file, 2015-08-07]
Design/CAD/mAEWing1.SLDASM
3067.4 x 279.4 x 1258.6 mm
inboard rib x 2
inboard rib keel attachment x 2
left center body
right center body
center body attach x 2
spar front top
spar rear
spar front bottom
spar front bottom right
spar front top right
spar rear right
keel x 2
tail hard point
motor mount base piece
motor mount piece
motor mount cover
motor - dummy
flight computer tray
flight computer - dummy
battery tray
battery - dummy
front battery - dummy
pitot tube - dummy
servo bracket left-spar attach
servo bracket left-servo attach
servo - dummy x 8
servo bracket right-spar attach
servo bracket right-servo attach
accel - dummy x 6
AvionicsCover
wing spar foam x 2
wing spar skin x 2
wing attach x 2
left inboard wing
left outboard wing
left wing washout
winglet attach x 2
winglet x 2
top front left reinforcement
top back left reinforcement
bottom front left reinforcement
bottom back left reinforcement
control surface x 6
AccelBracketLeftFwd
AccelBracketLeftAft
Mirror - left inboard wing1
Mirror - left outboard wing1
Mirror - left wing washout1
Mirror - top front left reinforcement1
Mirror - top back left reinforcement1
Mirror - bottom front left reinforcement1
Mirror - bottom back left reinforcement1
body flap x 2
flutter camera back
flutter camera
flutter camera mount
flutter camera mount cover
