zhaowei0566/mAEWing1/Design/CAD/Left Wing/left wing.SLDASM

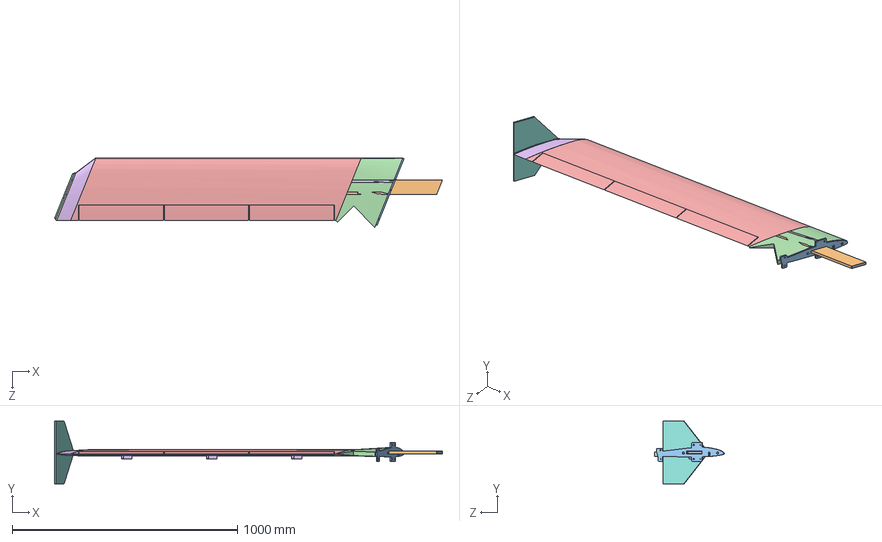
[picture p68: CAD file, 2015-08-07]
Design/CAD/Left Wing/left wing.SLDASM
1722.7 x 279.4 x 310.3 mm
wing spar foam
wing spar skin
wing attach
left inboard wing
left outboard wing
left wing washout
winglet attach
winglet
top front left reinforcement
top back left reinforcement
bottom front left reinforcement
bottom back left reinforcement
control surface x 3
servo - dummy x 3
accel - dummy x 2
AccelBracketLeftFwd
AccelBracketLeftAft
