zhaowei0566/mAEWing1/Design/CAD/Center Body/Motor Mount/motor mount assembly.SLDASM

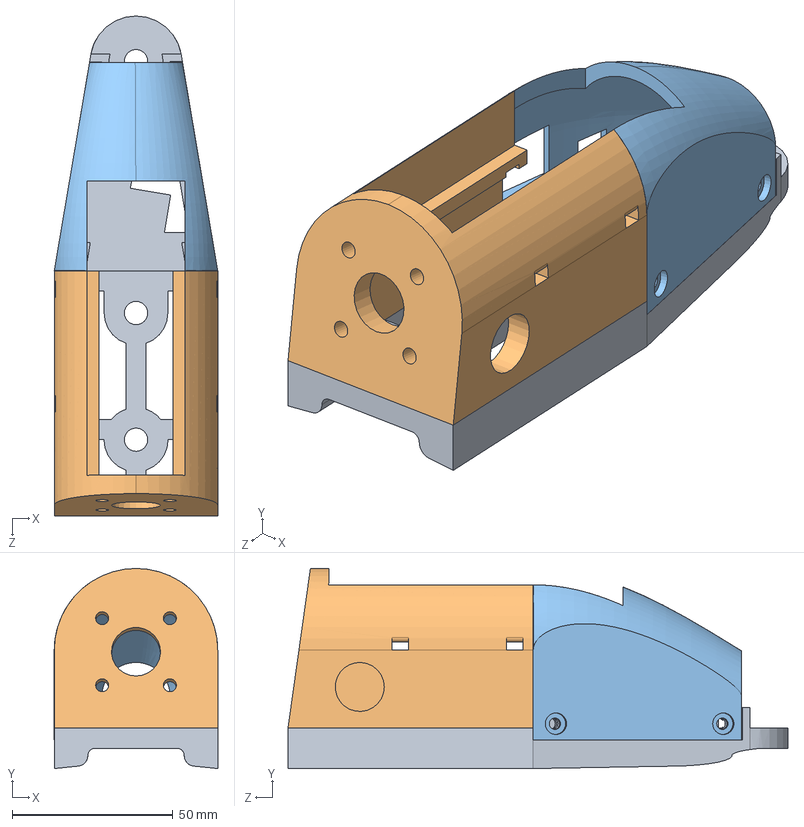
[picture p69: CAD file, 2015-07-17]
Design/CAD/Center Body/Motor Mount/motor mount assembly.SLDASM
50.8 x 62.2 x 155.4 mm
motor mount base piece
motor mount piece
motor mount cover
