zhaowei0566/mAEWing1/Design/CAD/Common Parts/wing spar.SLDASM

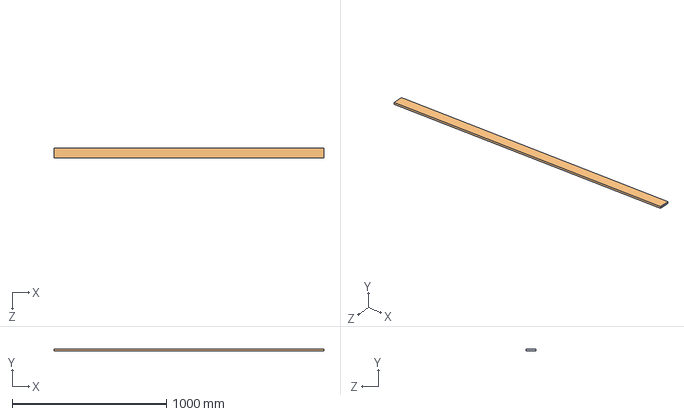
[picture p70: CAD file, 2015-07-17]
Design/CAD/Common Parts/wing spar.SLDASM
1752.6 x 11.4 x 63.5 mm
wing spar foam
wing spar skin
