zhaowei0566/mAEWing1/Design/CAD/Center Body/center body.SLDASM

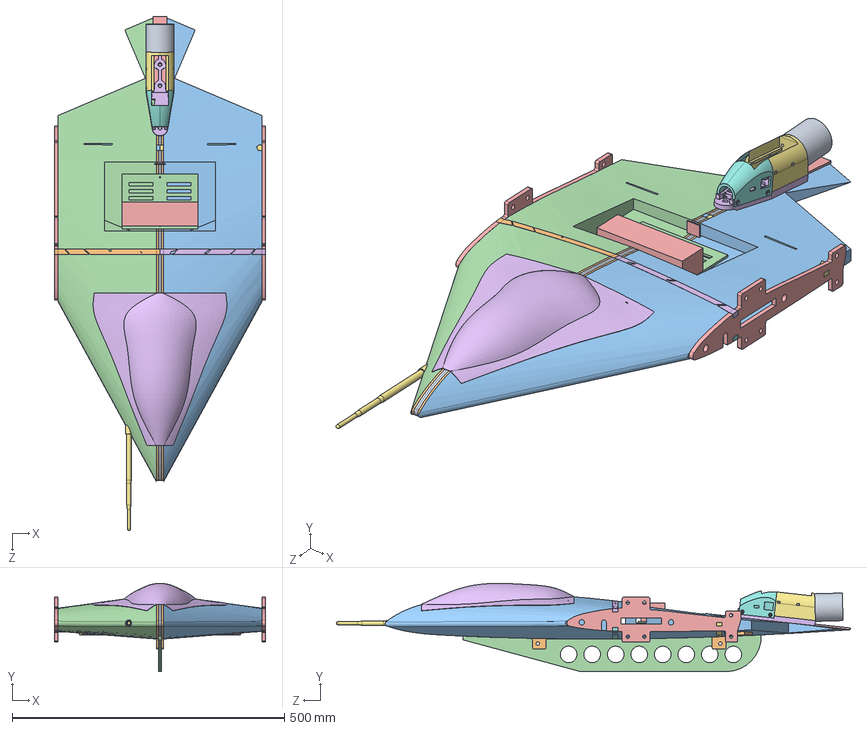
[picture p71: CAD file, 2015-07-17]
Design/CAD/Center Body/center body.SLDASM
387.4 x 162.1 x 944.3 mm
inboard rib x 2
inboard rib keel attachment x 2
left center body
right center body
center body attach x 2
spar front top
spar rear
spar front bottom
spar front bottom right
spar front top right
spar rear right
keel x 2
tail hard point
motor mount base piece
motor mount piece
motor mount cover
motor - dummy
flight computer tray
flight computer - dummy
battery tray
battery - dummy
front battery - dummy
pitot tube - dummy
servo bracket left-spar attach
servo bracket left-servo attach
servo - dummy x 2
servo bracket right-spar attach
servo bracket right-servo attach
accel - dummy x 2
AvionicsCover
