zhaowei0566/mAEWing1/Design/CAD/Center Body/body flap servo bracket/servo bracket right-servo attach.SLDPRT

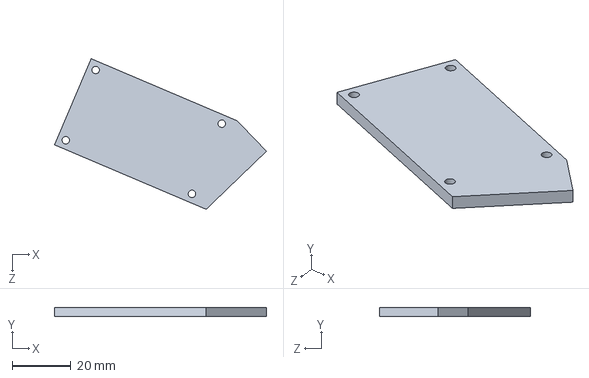
[picture p72: CAD file, 2015-07-17]
Design/CAD/Center Body/body flap servo bracket/servo bracket right-servo attach.SLDPRT
71.9 x 3.17 x 51.1 mm
