zhaowei0566/mAEWing1/Design/CAD/Center Body/Flight Computer Tray.SLDPRT

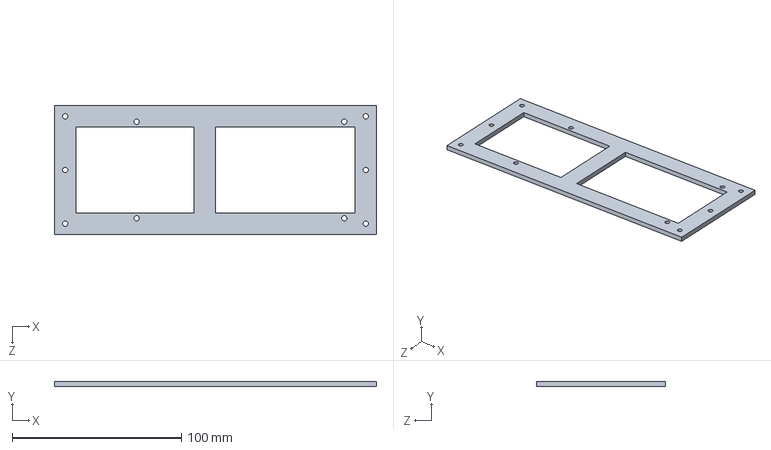
[picture p73: CAD file, 2016-05-19]
Design/CAD/Center Body/Flight Computer Tray.SLDPRT
190.5 x 3.05 x 76.2 mm
