zhaowei0566/mAEWing1/Design/CAD/Center Body/Motor Mount/motor mount cover.SLDPRT

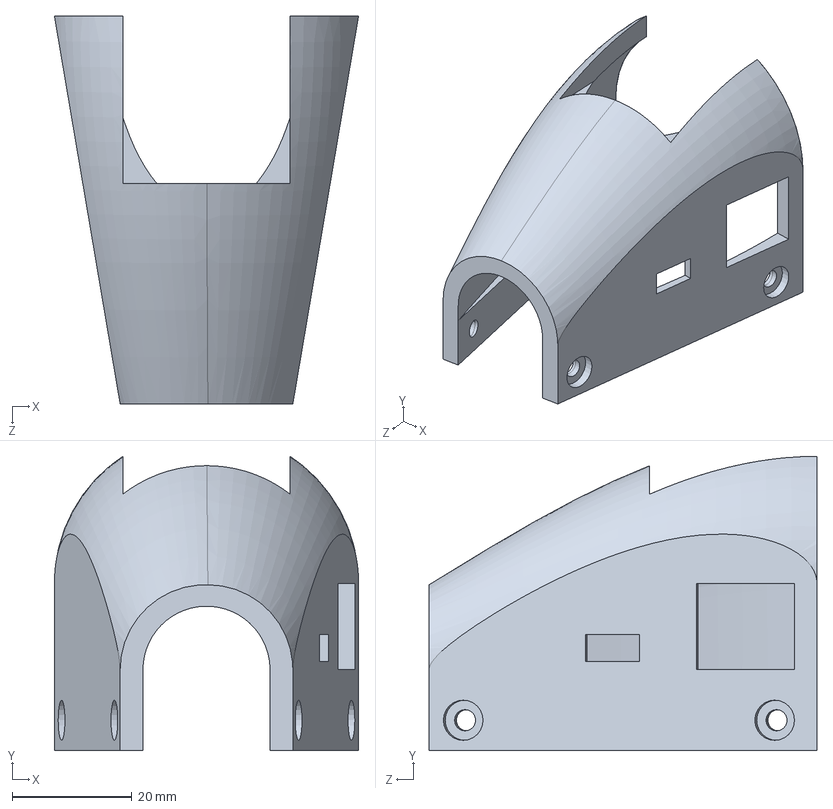
[picture p74: CAD file, 2015-07-17]
Design/CAD/Center Body/Motor Mount/motor mount cover.SLDPRT
50.8 x 49.2 x 64.8 mm
