zhaowei0566/mAEWing1/Design/CAD/Common Parts/winglet.SLDPRT

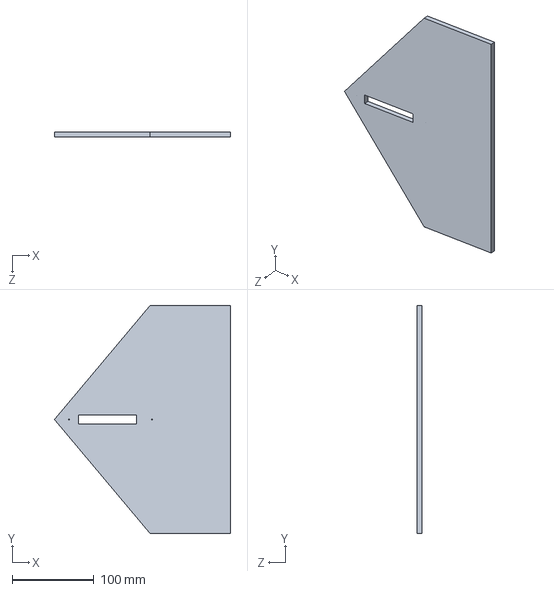
[picture p75: CAD file, 2015-07-17]
Design/CAD/Common Parts/winglet.SLDPRT
215.9 x 279.4 x 6.35 mm
