zhaowei0566/mAEWing1/Design/CAD/Fixtures/WingTipFixture.sldprt

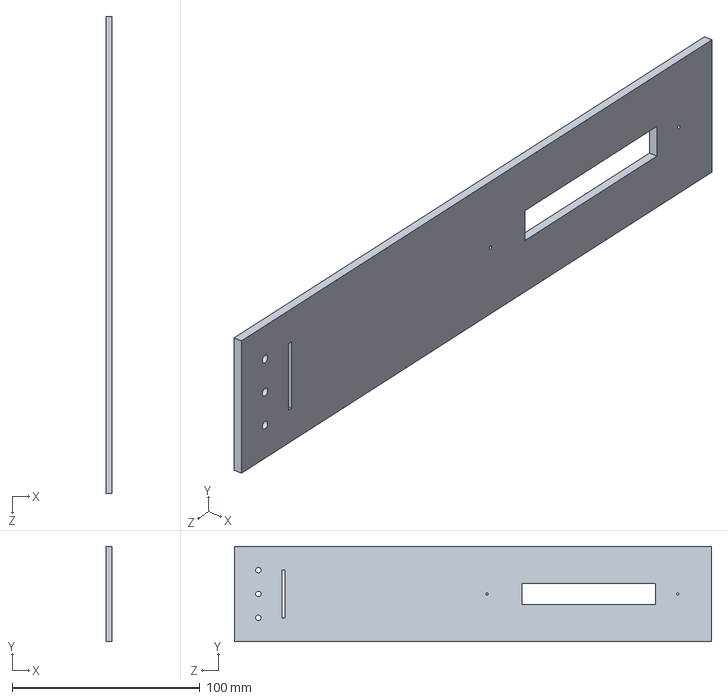
[picture p76: CAD file, 2015-07-17]
Design/CAD/Fixtures/WingTipFixture.sldprt
3.17 x 50.8 x 254.0 mm
