zhaowei0566/mAEWing1/Design/CAD/Left Wing/AccelBracketLeftAft.sldprt

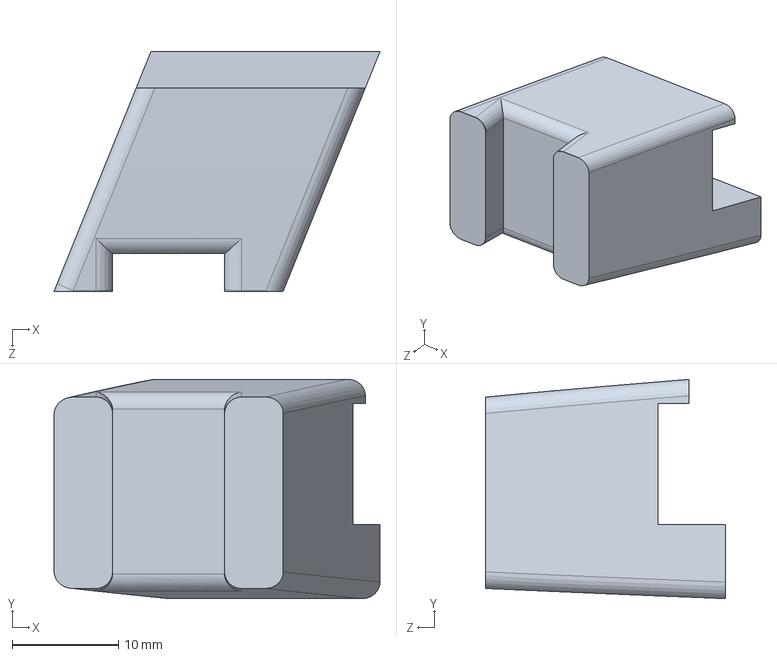
[picture p77: CAD file, 2015-08-07]
Design/CAD/Left Wing/AccelBracketLeftAft.sldprt
30.7 x 20.7 x 22.6 mm
