zhaowei0566/mAEWing1/Design/CAD/Center Body/body flap servo bracket/servo bracket right-spar attach.SLDPRT

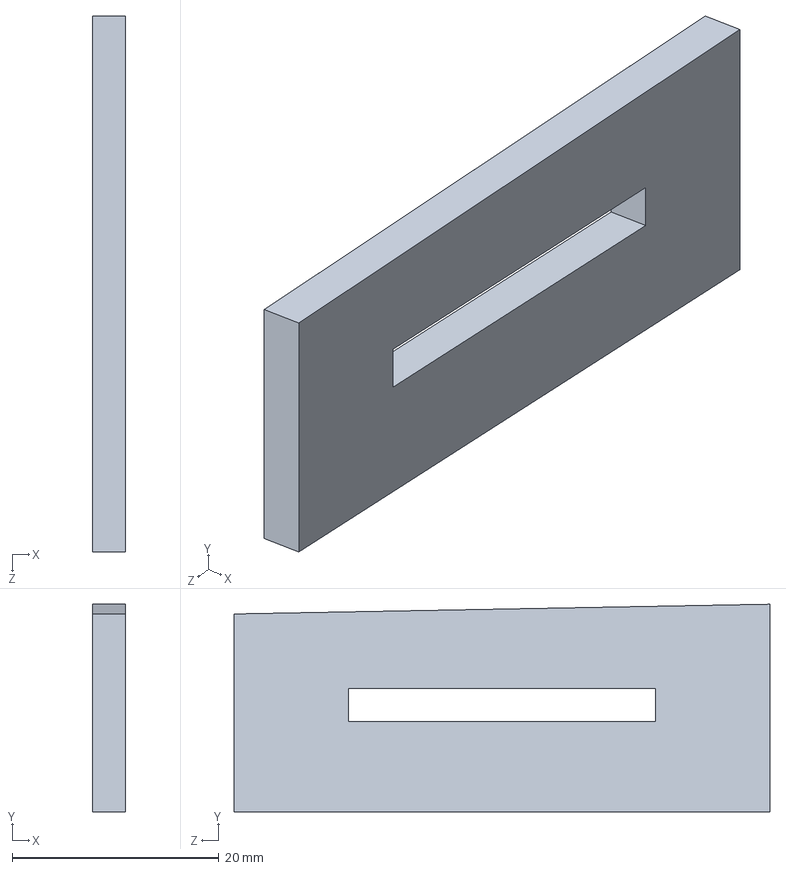
[picture p78: CAD file, 2015-07-17]
Design/CAD/Center Body/body flap servo bracket/servo bracket right-spar attach.SLDPRT
3.17 x 20.1 x 51.9 mm
