zhaowei0566/mAEWing1/Design/CAD/Center Body/flutter camera/flutter camera back.SLDPRT

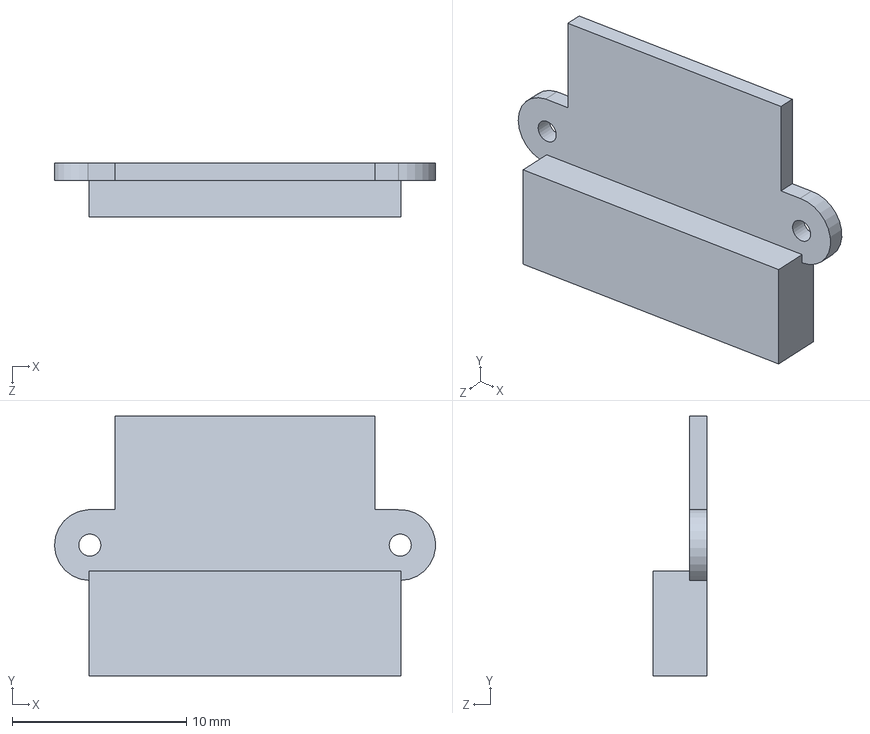
[picture p79: CAD file, 2015-07-17]
Design/CAD/Center Body/flutter camera/flutter camera back.SLDPRT
21.9 x 14.9 x 3.12 mm
