zhaowei0566/mAEWing1/Design/CAD/Center Body/Motor Mount/motor mount piece.SLDPRT

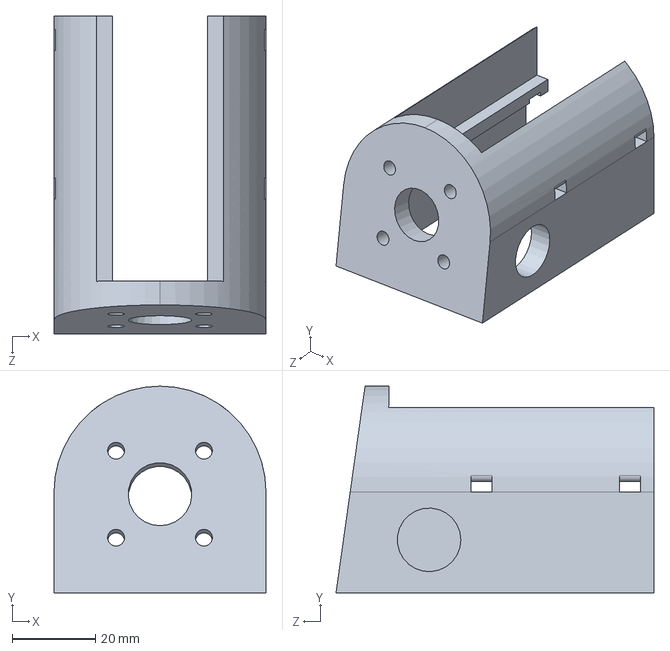
[picture p80: CAD file, 2015-07-17]
Design/CAD/Center Body/Motor Mount/motor mount piece.SLDPRT
50.8 x 49.5 x 76.2 mm
