zhaowei0566/mAEWing1/Design/CAD/Center Body/spar front top right.SLDPRT

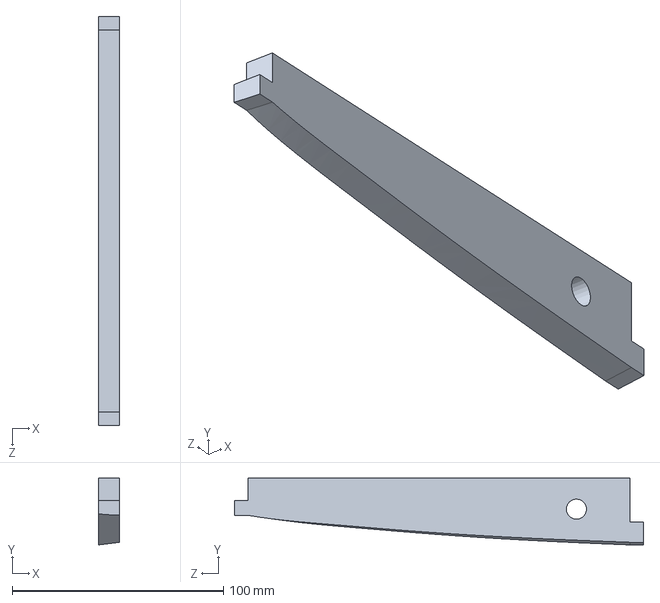
[picture p81: CAD file, 2015-07-17]
Design/CAD/Center Body/spar front top right.SLDPRT
10.2 x 31.7 x 193.7 mm
