zhaowei0566/mAEWing1/Design/CAD/Common Parts/winglet attach.SLDPRT

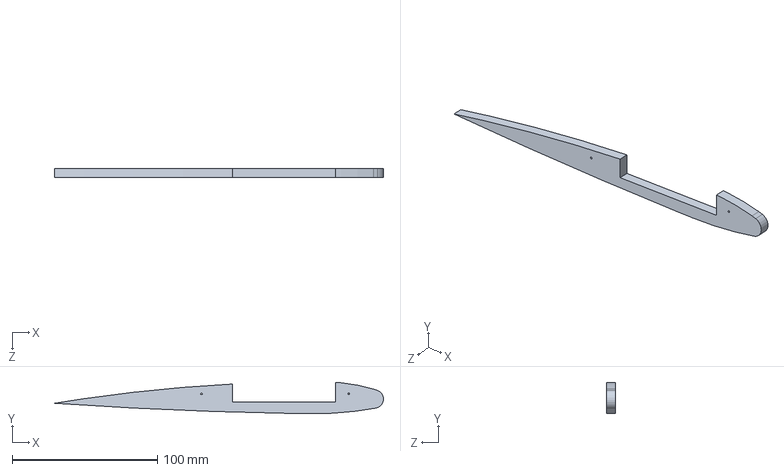
[picture p82: CAD file, 2015-07-17]
Design/CAD/Common Parts/winglet attach.SLDPRT
226.9 x 21.7 x 6.35 mm
