zhaowei0566/mAEWing1/Design/CAD/Fixtures/TopFixture.sldprt

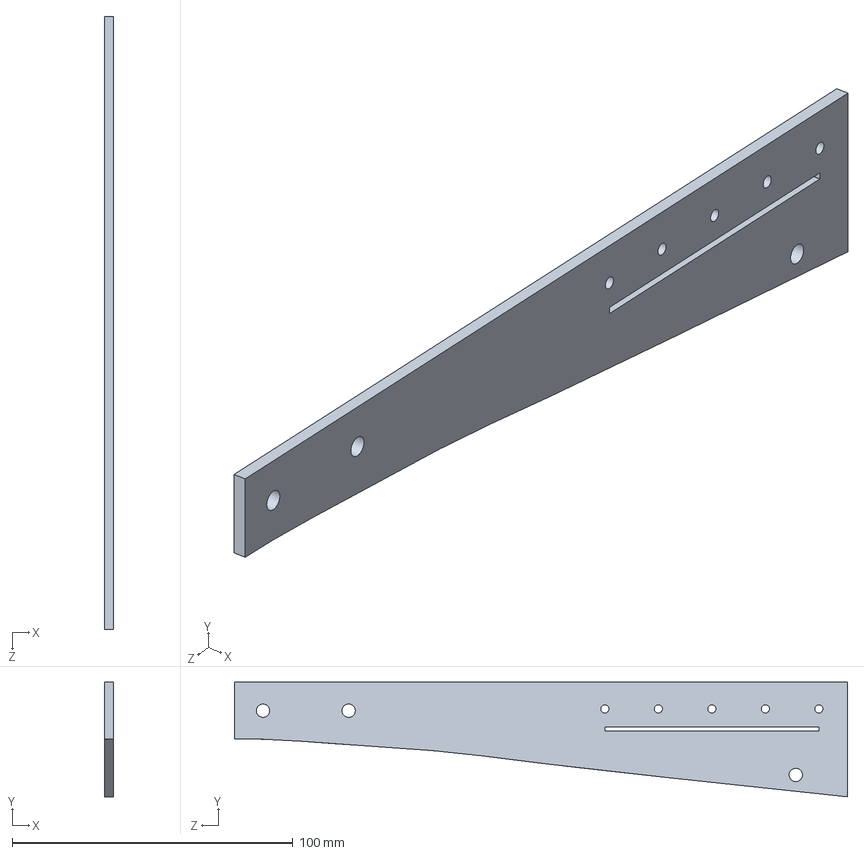
[picture p83: CAD file, 2015-07-17]
Design/CAD/Fixtures/TopFixture.sldprt
3.17 x 40.8 x 218.2 mm
