zhaowei0566/mAEWing1/Design/CAD/Center Body/flutter camera/flutter camera mount.SLDPRT

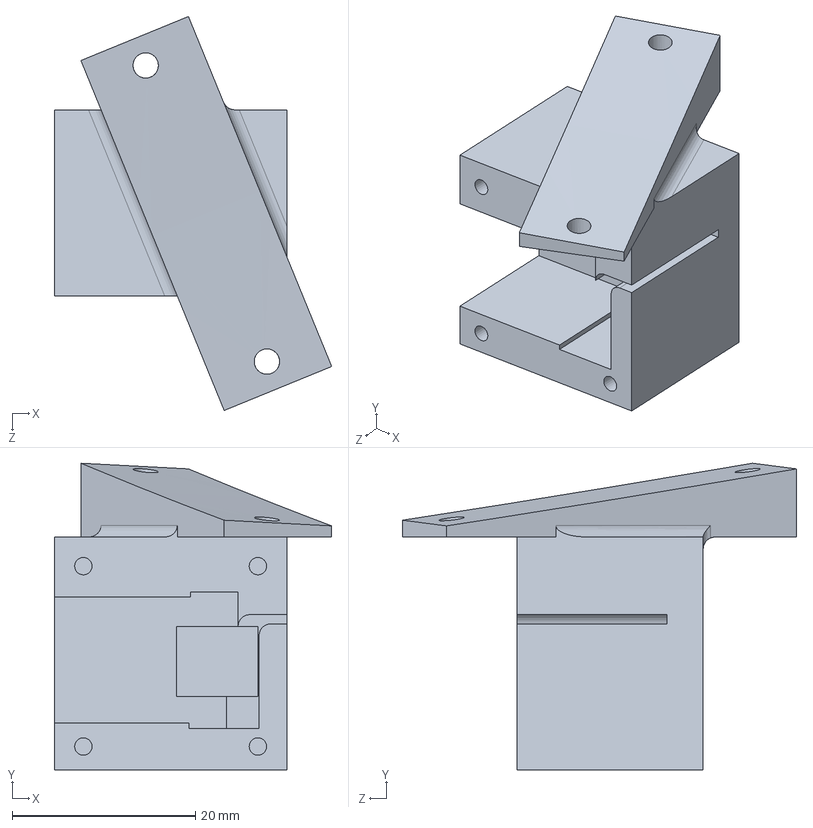
[picture p84: CAD file, 2015-07-17]
Design/CAD/Center Body/flutter camera/flutter camera mount.SLDPRT
30.3 x 33.5 x 43.0 mm
