zhaowei0566/mAEWing1/Design/CAD/Center Body/inboard rib.SLDPRT

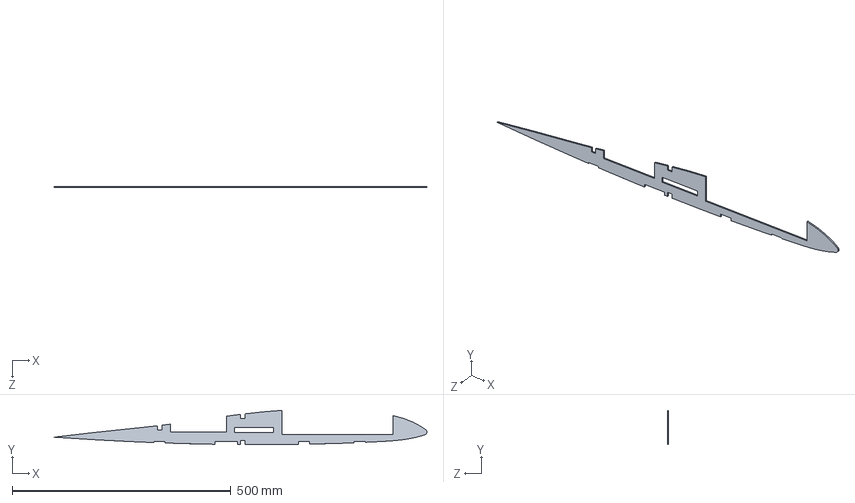
[picture p85: CAD file, 2015-07-17]
Design/CAD/Center Body/inboard rib.SLDPRT
852.2 x 78.3 x 3.18 mm
