zhaowei0566/mAEWing1/Design/CAD/Common Parts/control surface.sldprt

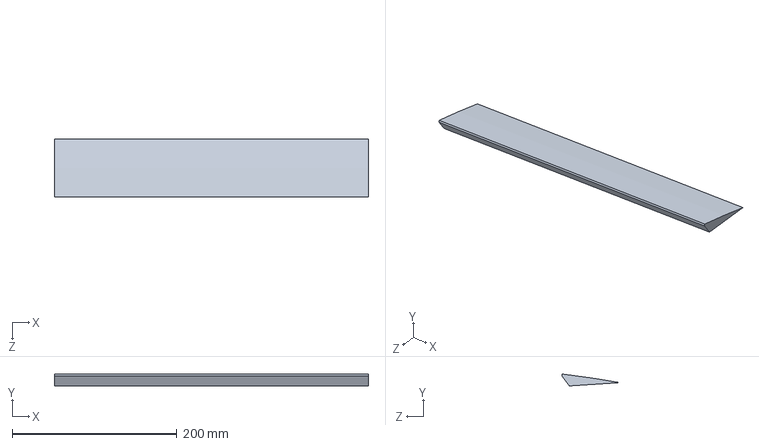
[picture p86: CAD file, 2015-07-17]
Design/CAD/Common Parts/control surface.sldprt
381.0 x 14.5 x 70.5 mm
