zhaowei0566/mAEWing1/Design/CAD/Fixtures/FrontFixture.sldprt

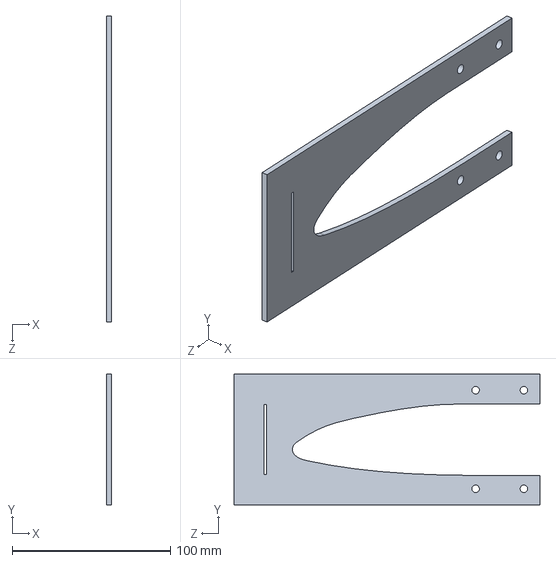
[picture p87: CAD file, 2015-07-17]
Design/CAD/Fixtures/FrontFixture.sldprt
3.17 x 82.6 x 193.1 mm
