zhaowei0566/mAEWing1/Design/CAD/Left Wing/AccelBracketLeftFwd.sldprt

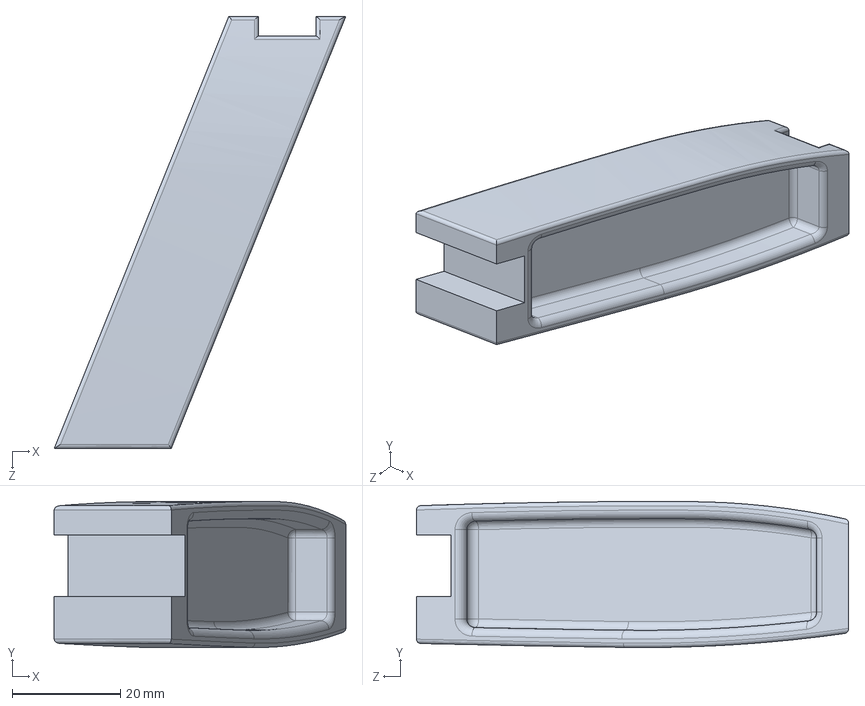
[picture p88: CAD file, 2015-08-07]
Design/CAD/Left Wing/AccelBracketLeftFwd.sldprt
53.8 x 27.0 x 79.8 mm
