zhaowei0566/mAEWing1/Design/CAD/Center Body/body flap servo bracket/servo bracket left-servo attach.SLDPRT

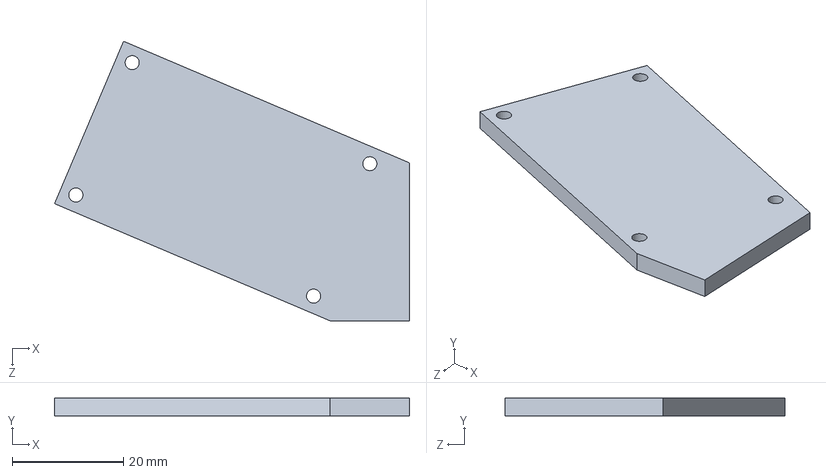
[picture p89: CAD file, 2015-07-17]
Design/CAD/Center Body/body flap servo bracket/servo bracket left-servo attach.SLDPRT
63.9 x 3.17 x 50.3 mm
