zhaowei0566/mAEWing1/Design/CAD/Center Body/flutter camera/flutter camera mount cover.SLDPRT

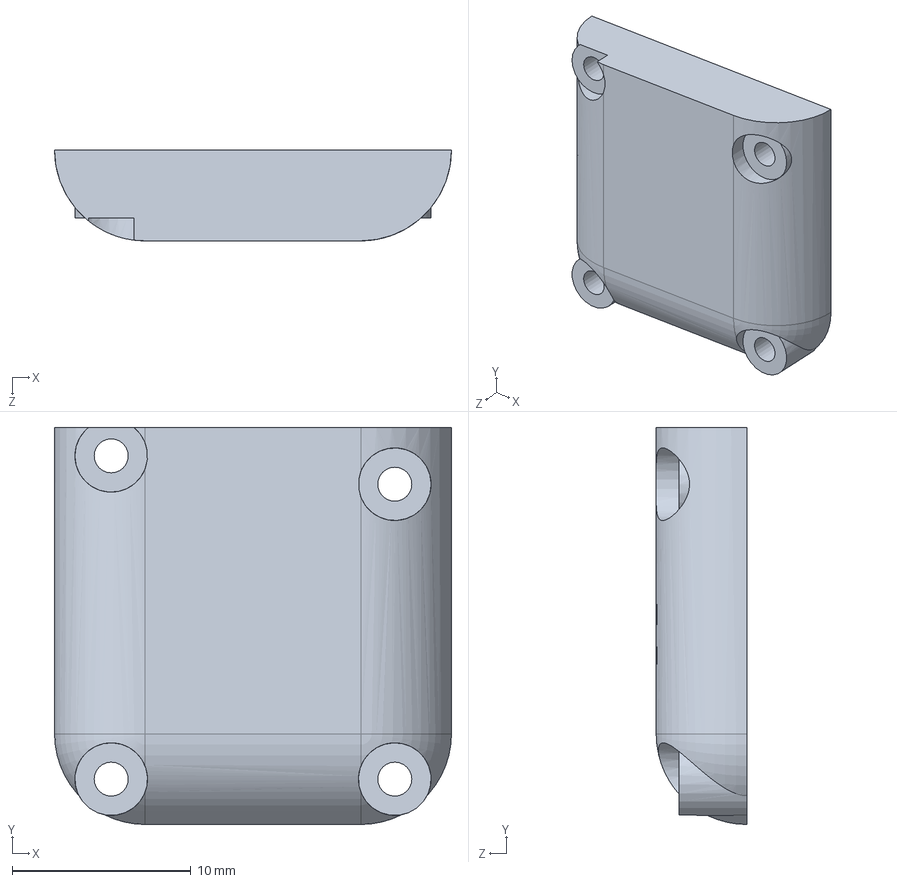
[picture p90: CAD file, 2015-07-17]
Design/CAD/Center Body/flutter camera/flutter camera mount cover.SLDPRT
22.2 x 22.2 x 5.08 mm
