zhaowei0566/mAEWing1/Design/CAD/Center Body/Motor Mount/motor mount base piece.SLDPRT

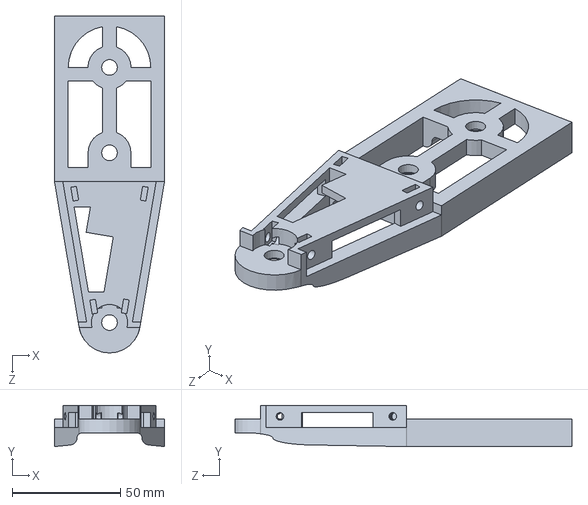
[picture p91: CAD file, 2015-07-17]
Design/CAD/Center Body/Motor Mount/motor mount base piece.SLDPRT
50.8 x 19.0 x 155.4 mm
