zhaowei0566/mAEWing1/Design/CAD/Center Body/spar rear right.SLDPRT

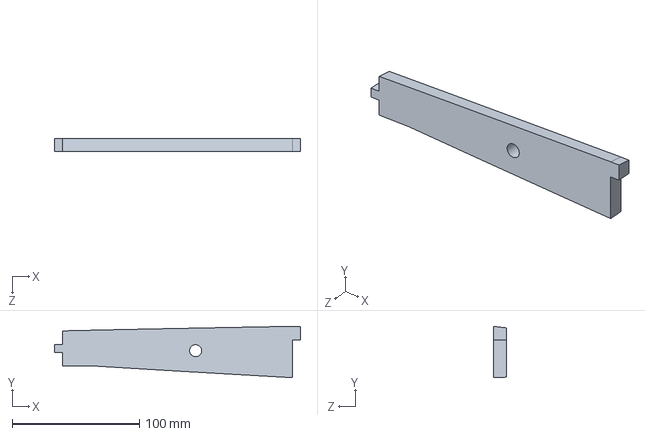
[picture p92: CAD file, 2015-07-17]
Design/CAD/Center Body/spar rear right.SLDPRT
193.7 x 40.4 x 10.2 mm
