zhaowei0566/mAEWing1/Design/CAD/Center Body/flutter camera/flutter camera.SLDPRT

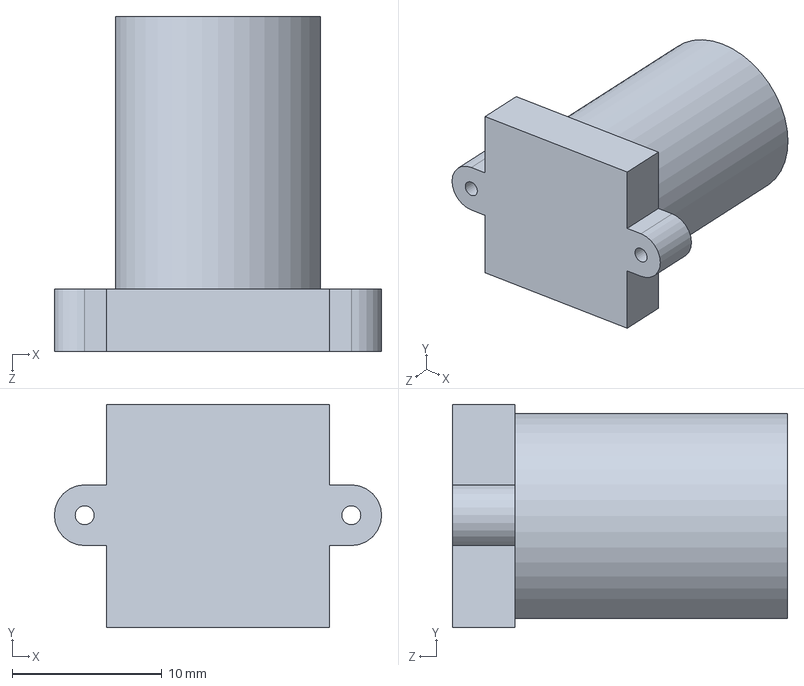
[picture p93: CAD file, 2015-07-17]
Design/CAD/Center Body/flutter camera/flutter camera.SLDPRT
21.9 x 14.9 x 22.4 mm
