zhaowei0566/mAEWing1/Design/CAD/Center Body/left center body.SLDPRT

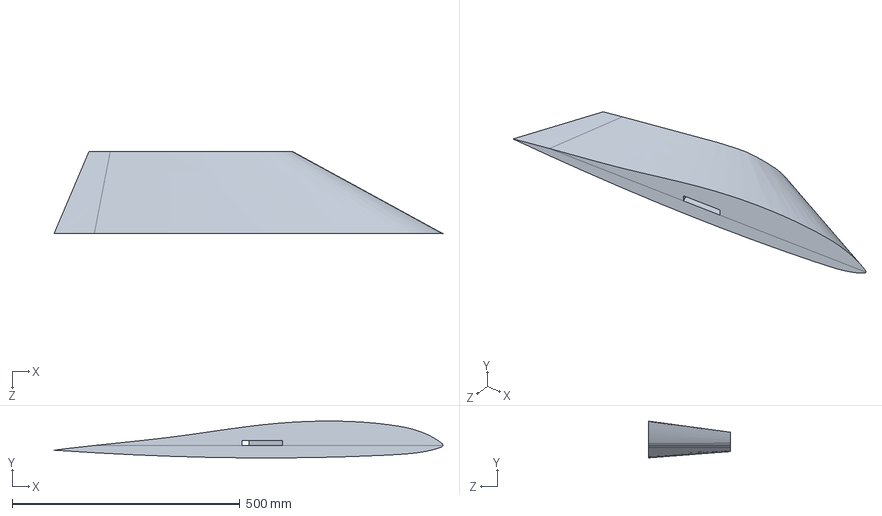
[picture p94: CAD file, 2015-07-17]
Design/CAD/Center Body/left center body.SLDPRT
854.5 x 81.0 x 181.0 mm
