zhaowei0566/mAEWing1/Design/CAD/Common Parts/servo - dummy.SLDPRT

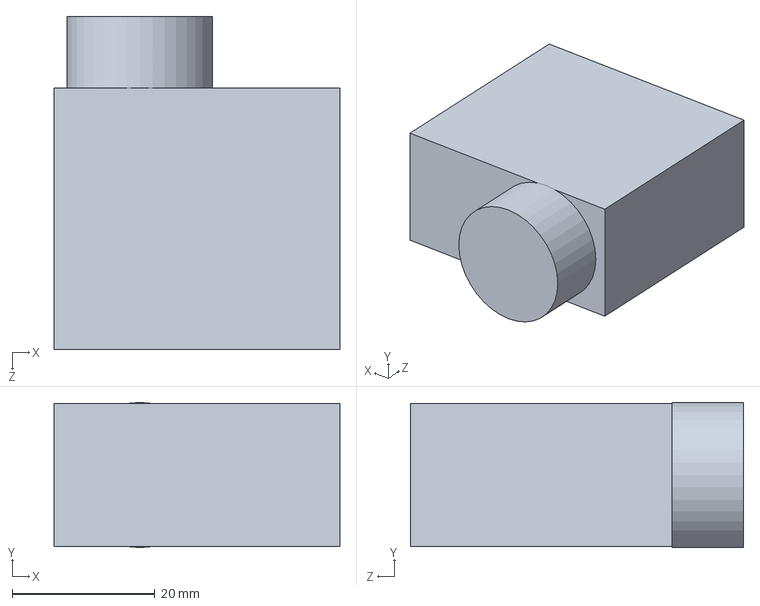
[picture p95: CAD file, 2015-07-17]
Design/CAD/Common Parts/servo - dummy.SLDPRT
40.0 x 20.3 x 46.6 mm
