zhaowei0566/mAEWing1/Design/CAD/Left Wing/left inboard wing.SLDPRT

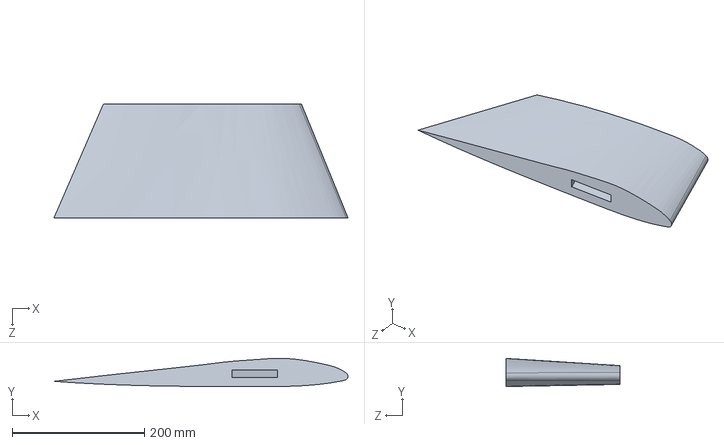
[picture p96: CAD file, 2015-07-17]
Design/CAD/Left Wing/left inboard wing.SLDPRT
443.9 x 42.6 x 171.4 mm
