zhaowei0566/mAEWing1/Design/CAD/Center Body/front battery - dummy.SLDPRT

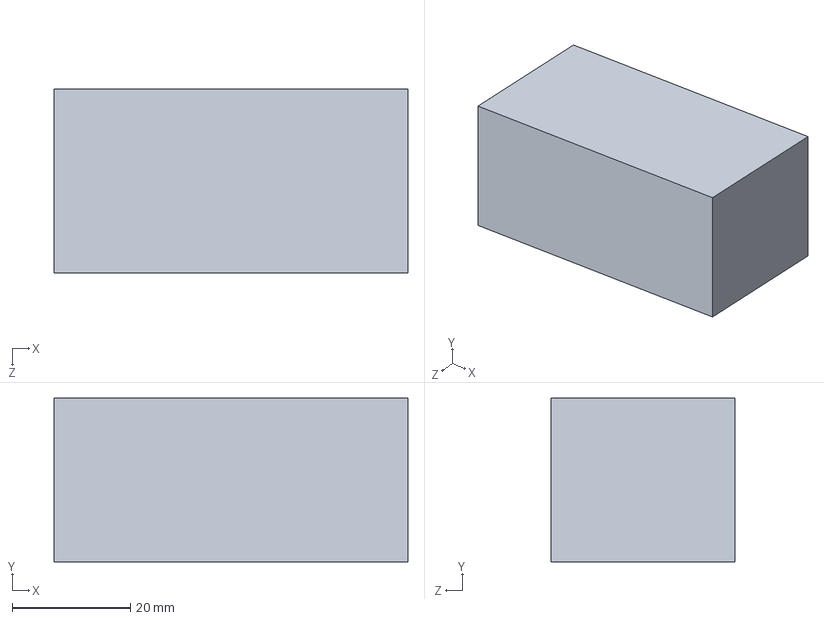
[picture p97: CAD file, 2015-07-17]
Design/CAD/Center Body/front battery - dummy.SLDPRT
59.8 x 27.7 x 31.2 mm
