zhaowei0566/mAEWing1/Design/CAD/Common Parts/wing attach.SLDPRT

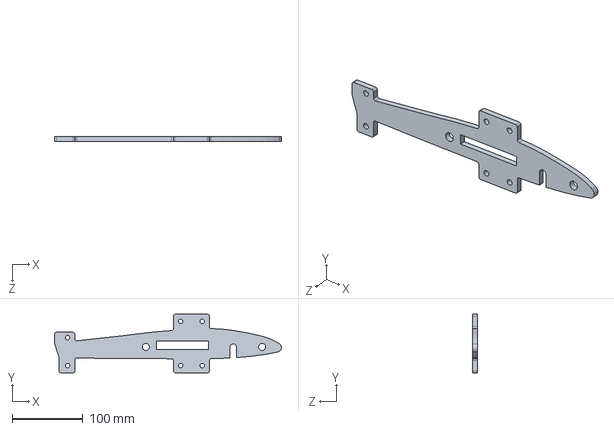
[picture p98: CAD file, 2015-07-17]
Design/CAD/Common Parts/wing attach.SLDPRT
319.8 x 82.6 x 6.35 mm
