zhaowei0566/mAEWing1/Design/CAD/Left Wing/left wing washout.SLDPRT

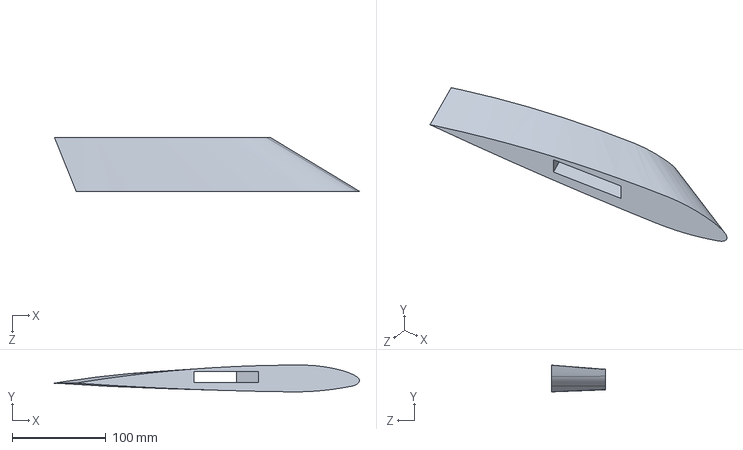
[picture p99: CAD file, 2015-07-17]
Design/CAD/Left Wing/left wing washout.SLDPRT
324.9 x 28.5 x 57.1 mm
