zhaowei0566/mAEWing1/Design/CAD/Common Parts/accel - dummy.SLDPRT

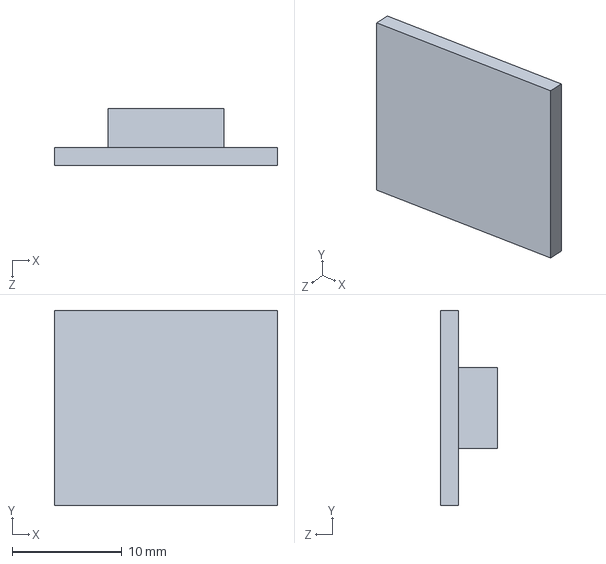
[picture p100: CAD file, 2015-07-17]
Design/CAD/Common Parts/accel - dummy.SLDPRT
20.3 x 17.8 x 5.16 mm
