zhaowei0566/mAEWing1/Design/CAD/Left Wing/left outboard wing.SLDPRT

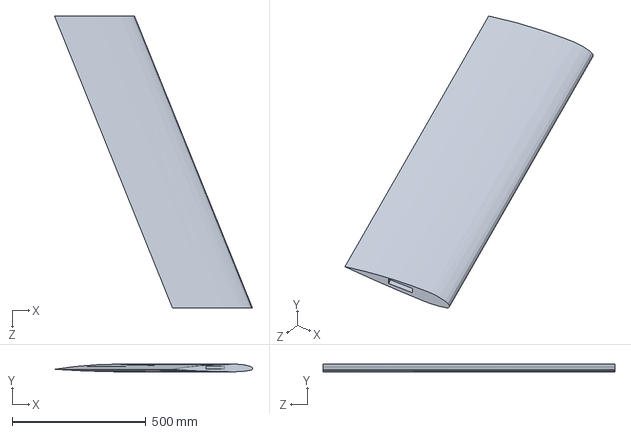
[picture p101: CAD file, 2015-07-17]
Design/CAD/Left Wing/left outboard wing.SLDPRT
740.6 x 28.5 x 1092.2 mm
