zhaowei0566/mAEWing1/Design/CAD/Center Body/keel.SLDPRT

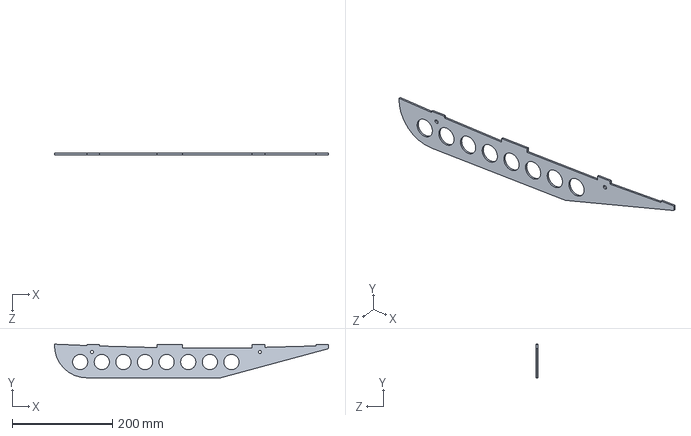
[picture p102: CAD file, 2015-07-17]
Design/CAD/Center Body/keel.SLDPRT
547.4 x 67.3 x 3.17 mm
