zhaowei0566/mAEWing1/Design/CAD/Common Parts/wing spar foam.SLDPRT

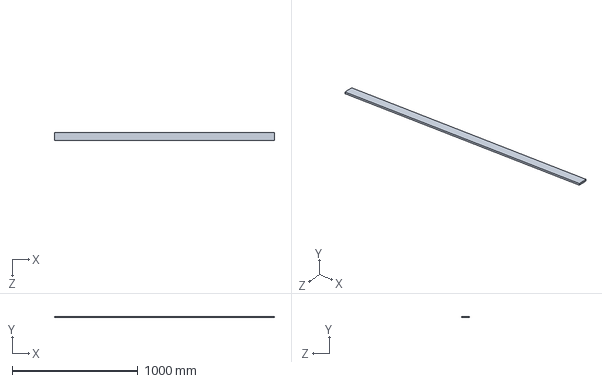
[picture p103: CAD file, 2015-07-17]
Design/CAD/Common Parts/wing spar foam.SLDPRT
1752.6 x 11.4 x 63.1 mm
