zhaowei0566/mAEWing1/Design/CAD/Center Body/spar front bottom right.SLDPRT

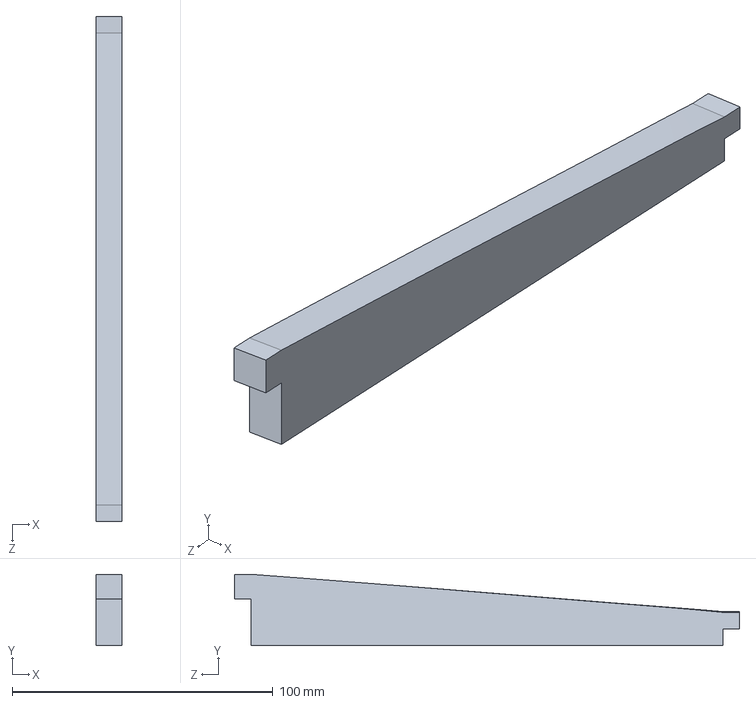
[picture p104: CAD file, 2015-07-17]
Design/CAD/Center Body/spar front bottom right.SLDPRT
10.2 x 27.4 x 193.7 mm
