zhaowei0566/mAEWing1/Design/CAD/Common Parts/body flap.SLDPRT

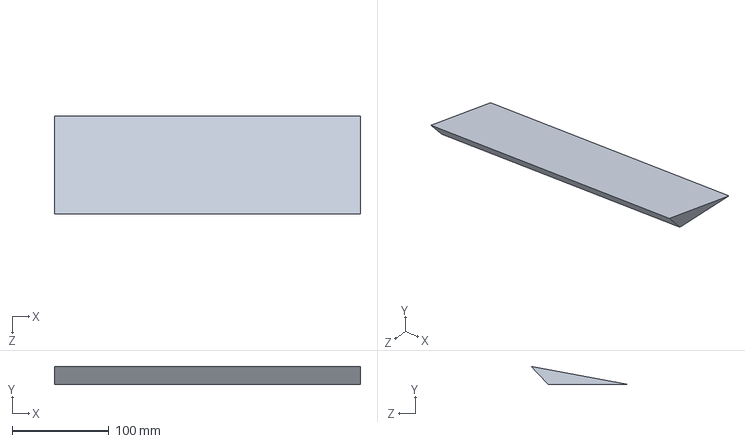
[picture p105: CAD file, 2015-07-17]
Design/CAD/Common Parts/body flap.SLDPRT
316.2 x 18.8 x 101.1 mm
