zhaowei0566/mAEWing1/Design/CAD/Center Body/battery - dummy.SLDPRT

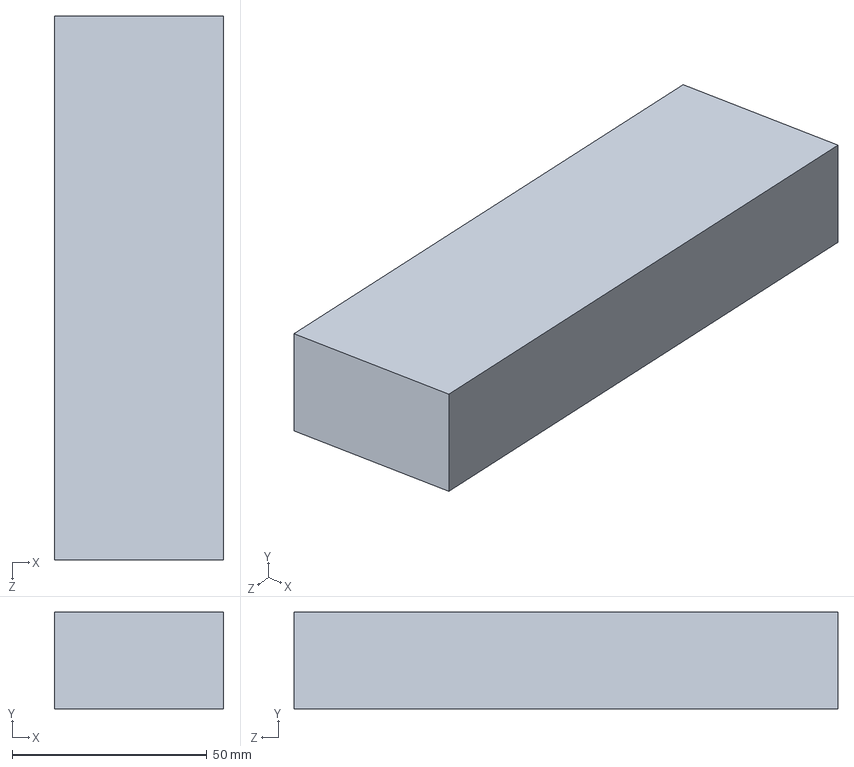
[picture p106: CAD file, 2015-07-17]
Design/CAD/Center Body/battery - dummy.SLDPRT
43.4 x 24.8 x 139.7 mm
