zhaowei0566/mAEWing1/Design/CAD/Center Body/pitot tube - dummy.SLDPRT

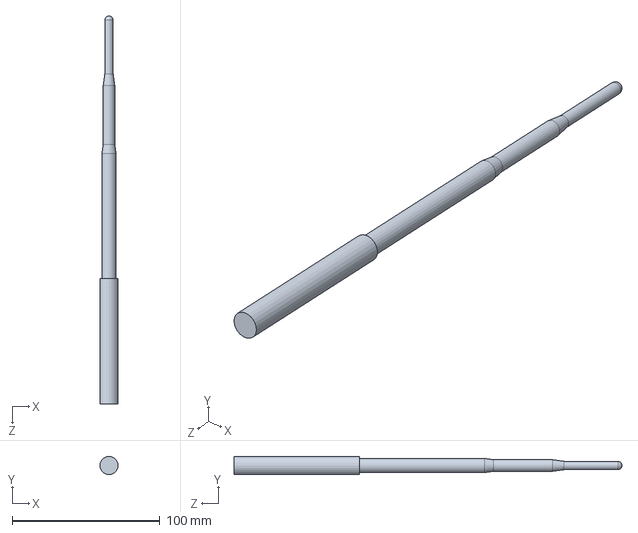
[picture p107: CAD file, 2015-07-17]
Design/CAD/Center Body/pitot tube - dummy.SLDPRT
12.3 x 12.3 x 262.4 mm
