zhaowei0566/mAEWing1/Design/CAD/Center Body/flight computer - dummy.SLDPRT

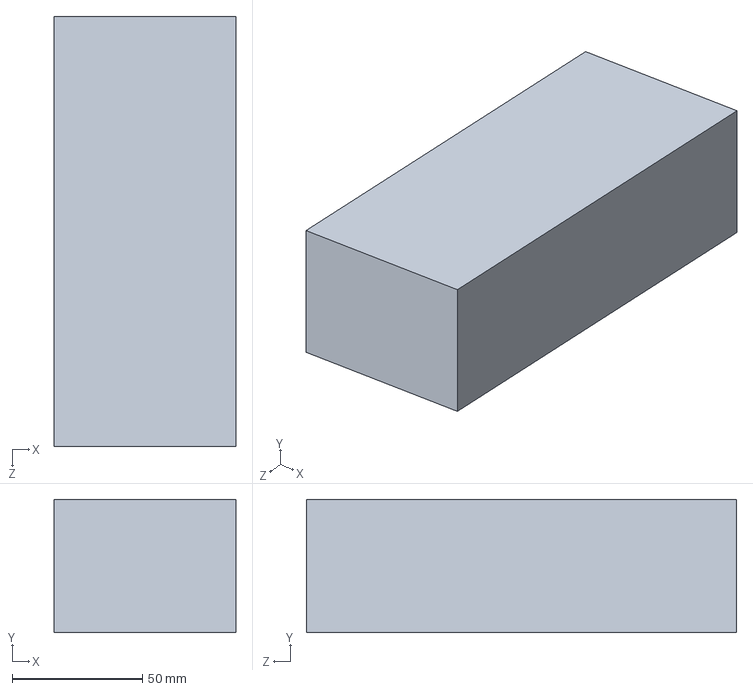
[picture p108: CAD file, 2015-07-17]
Design/CAD/Center Body/flight computer - dummy.SLDPRT
69.8 x 51.1 x 165.1 mm
