zhaowei0566/mAEWing1/Design/CAD/Center Body/tail hard point.SLDPRT

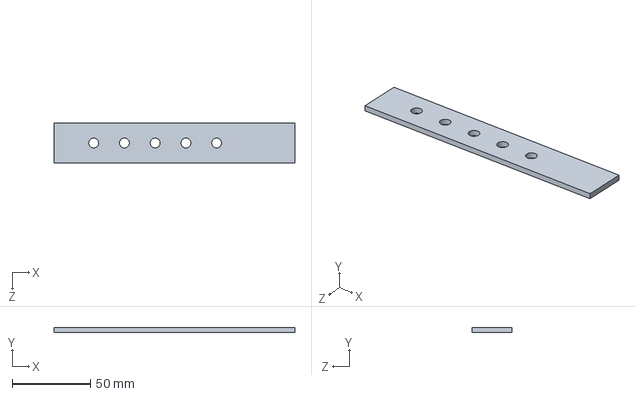
[picture p109: CAD file, 2015-07-17]
Design/CAD/Center Body/tail hard point.SLDPRT
154.3 x 3.17 x 25.4 mm
