zhaowei0566/mAEWing1/Design/CAD/Center Body/battery tray.SLDPRT

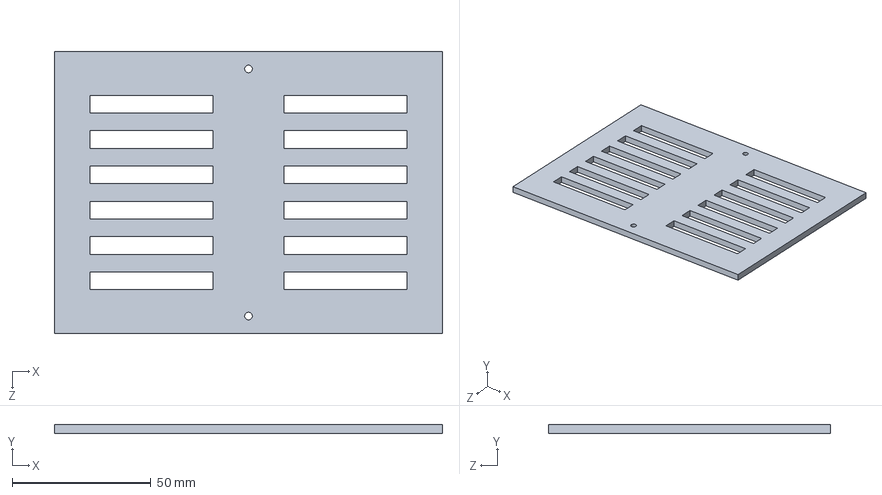
[picture p110: CAD file, 2015-07-17]
Design/CAD/Center Body/battery tray.SLDPRT
139.6 x 3.17 x 101.6 mm
