zhaowei0566/mAEWing1/Design/CAD/Center Body/motor - dummy.SLDPRT

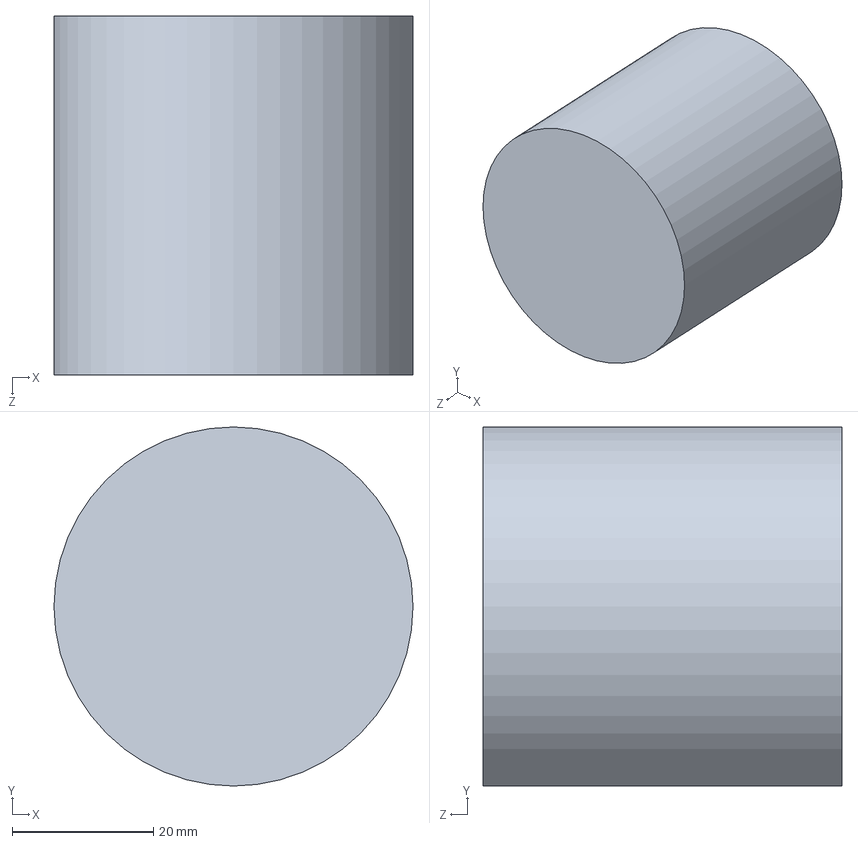
[picture p111: CAD file, 2015-07-17]
Design/CAD/Center Body/motor - dummy.SLDPRT
50.8 x 50.8 x 50.8 mm
