zhaowei0566/mAEWing1/Design/CAD/Center Body/inboard rib keel attachment.SLDPRT

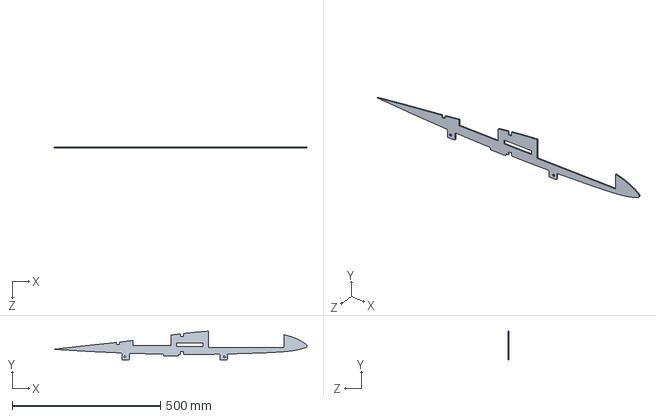
[picture p112: CAD file, 2015-07-17]
Design/CAD/Center Body/inboard rib keel attachment.SLDPRT
852.2 x 96.8 x 3.17 mm
