zhaowei0566/mAEWing1/Design/CAD/Center Body/AvionicsCover.sldprt

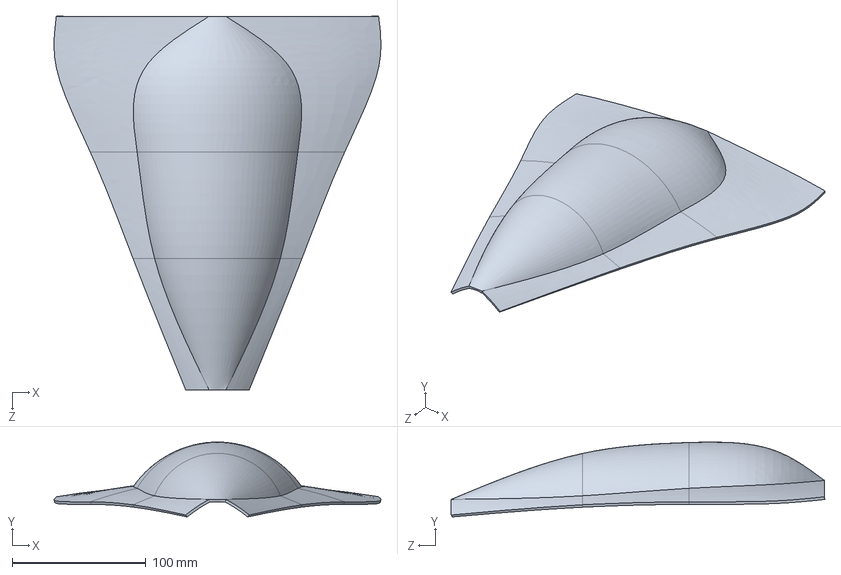
[picture p113: CAD file, 2015-07-17]
Design/CAD/Center Body/AvionicsCover.sldprt
244.7 x 56.1 x 279.6 mm
