zhaowei0566/mAEWing1/Design/CAD/Center Body/MobiusCameraImager.SLDPRT

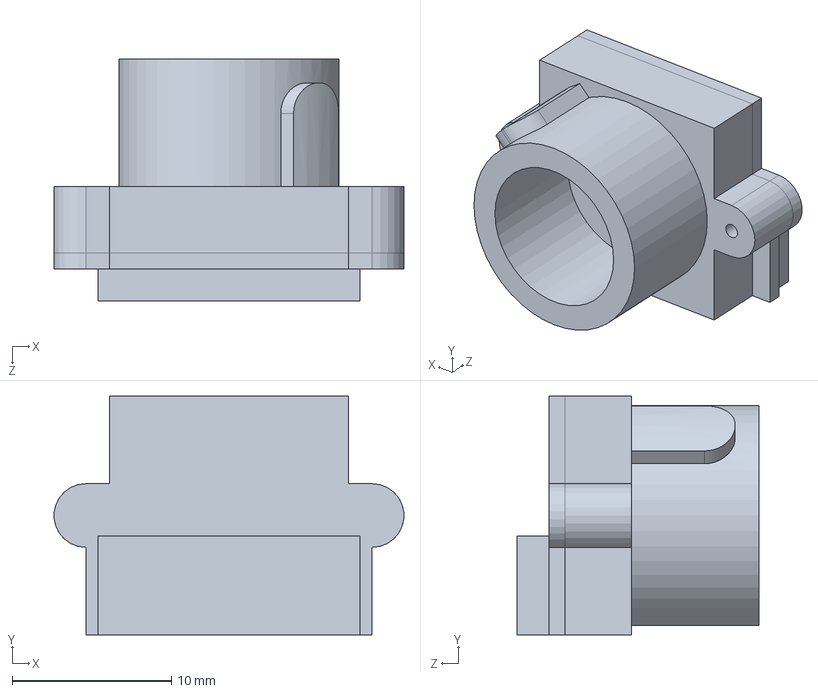
[picture p114: CAD file, 2015-06-29]
Design/CAD/Center Body/MobiusCameraImager.SLDPRT
22.0 x 15.0 x 15.2 mm
