zhaowei0566/mAEWing1/(list of files, cad)

Other CAD files:
Design/CAD/Right Wing/Mirror - left wing.SLDASM
Design/CAD/Right Wing/left wing - Mirror.SLDASM
Design/CAD/Right Wing/left wing1.SLDASM
Design/CAD/Right Wing/wing spar - Mirror.SLDASM
Design/CAD/Right Wing/right wing.SLDASM
Design/CAD/Right Wing/bottom front left reinforcement - Mirror.sldprt
Design/CAD/Center Body/body flap servo bracket/servo bracket left-spar attach.SLDPRT
Design/CAD/Right Wing/winglet attach - Mirror.SLDPRT
Design/CAD/Left Wing/top front left reinforcement.sldprt
Design/CAD/Right Wing/servo - dummy - Mirror.SLDPRT
Design/CAD/Common Parts/wing spar skin.sldprt
Design/CAD/Left Wing/bottom back left reinforcement.sldprt
Design/CAD/Center Body/spar rear.sldprt
Design/CAD/Right Wing/wing attach - Mirror.SLDPRT
Design/CAD/Right Wing/left wing washout - Mirror.SLDPRT
Design/CAD/Center Body/center body attach.SLDPRT
Design/CAD/Right Wing/AccelBracketLeftFwd - Mirror.sldprt
Design/CAD/Left Wing/top back left reinforcement.sldprt
Design/CAD/Right Wing/top front left reinforcement - Mirror.sldprt
Design/CAD/Left Wing/bottom front left reinforcement.sldprt
Design/CAD/Right Wing/wing spar foam - Mirror.SLDPRT
Design/CAD/Right Wing/left inboard wing - Mirror.SLDPRT
Design/CAD/Center Body/spar front top.sldprt
Design/CAD/Right Wing/bottom back left reinforcement - Mirror.sldprt
Design/CAD/Right Wing/winglet - Mirror.SLDPRT
Design/CAD/Center Body/right center body.SLDPRT
Design/CAD/Right Wing/accel - dummy - Mirror.SLDPRT
Design/CAD/Right Wing/control surface - Mirror.sldprt
Design/CAD/Right Wing/AccelBracketLeftAft - Mirror.sldprt
Design/CAD/Right Wing/wing spar skin - Mirror.sldprt
Design/CAD/Right Wing/top back left reinforcement - Mirror.sldprt
Design/CAD/Center Body/spar front bottom.sldprt
Design/CAD/Right Wing/left outboard wing - Mirror.SLDPRT
Design/CAD/Right Wing/Mirror - left outboard wing1.SLDPRT
Design/CAD/Right Wing/Mirror - top front left reinforcement1.sldprt
Design/CAD/Right Wing/Mirror - bottom back left reinforcement1.sldprt
Design/CAD/Right Wing/Mirror - left wing washout1.SLDPRT
Design/CAD/Right Wing/Mirror - bottom front left reinforcement1.sldprt
Design/CAD/Right Wing/Mirror - top back left reinforcement1.sldprt
Design/CAD/Right Wing/Mirror - left inboard wing1.SLDPRT
Design/CAD/Drawings/center body.SLDDRW
Design/CAD/Drawings/left wing.SLDDRW
Design/CAD/Drawings/mAEWing1.SLDDRW
Design/CAD/Drawings/servo bracket left-servo attach.SLDDRW
