zhaowei0566/mAEWing1/Design/CAD/mAEWing1 - Wiring Guide.xlsx

Sheet: Accelerometers
Left Wing Forward Accelerometer |  |  |  |  | Centerbody Forward Accelerometer |  |  |  |  | Right Wing Forward Accelerometer
Pin | Description | Color | Type | Notes | Pin | Description | Color | Type | Notes | Pin | Description | Color | Type | Notes
5 | V_OUT (Signal) | Blue | 24 awg |  | 5 | V_OUT (Signal) | Blue | 24 awg |  | 5 | V_OUT (Signal) | Blue | 24 awg
7 | V_SS (Ground) | Black | 24 awg |  | 7 | V_SS (Ground) | Black | 24 awg |  | 7 | V_SS (Ground) | Black | 24 awg
8 | V_DD (5V) | Red | 24 awg |  | 8 | V_DD (5V) | Red | 24 awg |  | 8 | V_DD (5V) | Red | 24 awg
Left Wing Aft Accelerometer |  |  |  |  | Centerbody Aft Accelerometer |  |  |  |  | Right Wing Aft Accelerometer
Pin | Description | Color | Type | Notes | Pin | Description | Color | Type | Notes | Pin | Description | Color | Type | Notes
5 | V_OUT (Signal) | Green | 24 awg |  | 5 | V_OUT (Signal) | Green | 24 awg |  | 5 | V_OUT (Signal) | Green | 24 awg
7 | V_SS (Ground) | Black | 24 awg |  | 7 | V_SS (Ground) | Black | 24 awg |  | 7 | V_SS (Ground) | Black | 24 awg
8 | V_DD (5V) | Red | 24 awg |  | 8 | V_DD (5V) | Red | 24 awg |  | 8 | V_DD (5V) | Red | 24 awg
General Notes: |  |  |  |  |  |  |  |  |  |  |  |  |  |  | N/C | 1 |  | 16 | N/C
All wires soldered direct to header pins |  |  |  |  |  |  |  |  |  |  |  |  |  |  | N/C | 2 | PA0006 | 15 | N/C
Extra header pins may be removed (Keep at least 4 - 8) |  |  |  |  |  |  |  |  |  |  |  |  |  |  | N/C | 3 | MMA2240KEG | 14 | N/C
Long runs should be twisted, isolate signal-to-signal |  |  |  |  |  |  |  |  |  |  |  |  |  |  | ST | 4 |  | 13 | N/C
Pwr & Gnd are split from the wing attach to each accel in the wing |  |  |  |  |  |  |  |  |  |  |  |  |  |  | V_OUT | 5 |  | 12 | N/C
 |  |  |  |  |  |  |  |  |  |  |  |  |  |  | STATUS | 6 |  | 11 | N/C
 |  |  |  |  |  |  |  |  |  |  |  |  |  |  | V_SS | 7 |  | 10 | N/C
 |  |  |  |  |  |  |  |  |  |  |  |  |  |  | V_DD | 8 |  | 9 | N/C

Sheet: Wing Attach Harness
Left/Right Wing Attach - Wing Side - Molex-Fit JR "Recepticle" (Male housing w/ female contacts)
Pin | Description | Color | Type | Notes
1 | Servo L2/R2 Ground | Black | 24 awg | to Servo Type J connector (black)
2 | Servo L2/R2 Power (4.8V) | Red | 24 awg | to Servo Type J connector (red)
3 | Servo L2/R2 Signal | White/Yellow | 24 awg | to Servo Type J connector (white)
4 | Servo L3/R3 Ground | Black | 24 awg | to Servo Type J connector (black)
5 | Servo L3/R3 Power (4.8V) | Red | 24 awg | to Servo Type J connector (red)
6 | Servo L3/R3 Signal | White/Yellow | 24 awg | to Servo Type J connector (white)
7
8 | Servo L4/R4 Ground | Black | 24 awg | to Servo Type J connector (black)
9 | Servo L4/R4 Power (4.8V) | Red | 24 awg | to Servo Type J connector (red)
10 | Servo L4/R4 Signal | White/Yellow | 24 awg | to Servo Type J connector (white)
11 | Accel Ground | Black | 24 awg | Split to both accelerometer boards, hardwired
12 | Accel Power (5V) | Red | 24 awg | Split to both accelerometer boards, hardwired
13 | Front Accel Signal | Blue | 24 awg | hardwired at accelerometer pcb
14 | Aft Accel Signal | Green | 24 awg | hardwired at accelerometer pcb
Left/Right Wing Attach - Centerbody Side - Molex-Fit JR "Plug" (Female housing w/ male contacts)
Pin | Description | Color | Type | Notes
1 | Servo L2/R2 Ground | Black | 24 awg | Servo Ground common across connector
2 | Servo L2/R2 Power (4.8V) | Red | 24 awg | Servo Pwr common across connector
3 | Servo L2/R2 Signal | White/Yellow | 24 awg
4 | Servo L3/R3 Ground | Black | 24 awg | Servo Ground common across connector
5 | Servo L3/R3 Power (4.8V) | Red | 24 awg | Servo Pwr common across connector
6 | Servo L3/R3 Signal | White/Yellow | 24 awg
7
8 | Servo L4/R4 Ground | Black | 24 awg | Servo Ground common across connector
9 | Servo L4/R4 Power (4.8V) | Red | 24 awg | Servo Pwr common across connector
10 | Servo L4/R4 Signal | White/Yellow | 24 awg
11 | Accel Ground | Black | 24 awg
12 | Accel Power (5V) | Red | 24 awg
13 | Front Accel Signal | Blue | 24 awg
14 | Aft Accel Signal | Green | 24 awg
General Notes:
Molex Mini-Fit JR "Recepticle" (with Female contacts) should be on the wing/outboard side of harnesses

Sheet: ADC and Filter
Analog Filter / ADC - Left Wing (front and aft) + Aft Centerbody |  |  |  |  |  |  |  |  |  |  |  |  |  |  |  |  |  | Analog Filter / ADC - Left Wing (front and aft) + Front Centerbody
Pin | Description | Color | Type | Notes | Accel Pwr | 1 |  | V BATT |  | Accel Analog Filter |  |  |  |  | SCL | 1 | I2C SCL | Pin | Description | Color | Type | Notes
1 | Accel Pwr (5V) | Red | 24 awg | Split to wing attach and Front CB Accel |  |  | Isolate |  |  |  |  |  |  |  |  |  |  | 1 | I2C SCL | white | 24 awg
2 | Accel Gnd | Black | 24 awg | Split to wing attach and Front CB Accel | Accel Gnd | 2 |  | V SS | AC 3 | 1 |  |  | 16 | AC 2 | SDA | 2 | I2C SDA | 2 | I2C SDA | purple | 24 awg
3 | Wing Front Accel Signal | Blue | 24 awg |  |  |  |  |  | AC 6 | 2 | PA0060 |  | 15 | V PUMP |  |  |  | 3 | I2C Power (Supply 5V) | green | 24 awg
4 | Wing Front Accel Gnd |  |  | Jumper to Pin 2 (Accel Ground) on pcb | Wing Frnt Sig | 3 |  | AC 3 | AC 7 | 3 | SX8724C |  | 14 | SCL | V BATT | 3 | I2C Pwr | 4 | I2C Ground (Supply Side) | yellow | 24 awg
5 | Wing Aft Accel Signal | Green | 24 awg |  |  |  | Filt |  | AC 4 | 4 |  |  | 13 | SDA
6 | Wing Aft Accel Gnd |  |  | Jumper to Pin 2 (Accel Ground) on pcb | Wing Frnt Gnd | 4 |  | AC 2 | AC 5 | 5 |  |  | 12 | D0 | V SS | 4 | I2C Gnd
7 | Centerbody Accel Signal | Green | 24 awg |  |  |  |  |  | V BATT | 6 |  |  | 11 | D2
8 | Centerbody Accel Gnd |  |  | Jumper to Pin 2 (Accel Ground) on pcb | Wing Aft Sig | 5 |  | AC 5 | V SS | 7 |  |  | 10 | D3
 |  |  |  |  |  |  | Filt |  | READY | 8 |  |  | 9 | D1
 |  |  |  |  | Wing Aft Gnd | 6 |  | AC 4
 |  |  |  |  | CntB Sig | 7 |  | AC 7
 |  |  |  |  |  |  | Filt
 |  |  |  |  | CntB Gnd | 8 |  | AC 6
 |  |  |  |  |  |  | * Connect V BATT to D0 with a Resistor to set I2C address to 100XX01
Analog Filter / ADC - Right Wing (front and aft) + Front Centerbody |  |  |  |  | Accel Pwr | 1 |  | V BATT |  | Accel Analog Filter |  |  |  |  | SCL | 1 | I2C SCL | Analog Filter / ADC - Right Wing (front and aft) + Aft Centerbody
Pin | Description | Color | Type | Notes |  |  | Isolate |  |  |  |  |  |  |  |  |  |  | Pin | Description | Color | Type | Notes
1 | Accel Pwr (5V) | Red | 24 awg | Split to wing attach and Aft CB Accel | Accel Gnd | 2 |  | V SS | AC 3 | 1 |  |  | 16 | AC 2 | SDA | 2 | I2C SDA | 1 | I2C SCL | white | 24 awg
2 | Accel Gnd | Black | 24 awg | Split to wing attach and Aft CB Accel |  |  |  |  | AC 6 | 2 | PA0060 |  | 15 | V PUMP |  |  |  | 2 | I2C SDA | purple | 24 awg
3 | Wing Front Accel Signal | Blue | 24 awg |  | Wing Frnt Sig | 3 |  | AC 3 | AC 7 | 3 | SX8724C |  | 14 | SCL | V BATT | 3 | I2C Pwr | 3 | I2C Power (Supply 5V) | green | 24 awg
4 | Wing Front Accel Gnd |  |  | Jumper to Pin 2 (Accel Ground) on pcb |  |  | Filt |  | AC 4 | 4 |  |  | 13 | SDA |  |  |  | 4 | I2C Ground (Supply Side) | yellow | 24 awg
5 | Wing Aft Accel Signal | Green | 24 awg |  | Wing Frnt Gnd | 4 |  | AC 2 | AC 5 | 5 |  |  | 12 | D0 | V SS | 4 | I2C Gnd
6 | Wing Aft Accel Gnd |  |  | Jumper to Pin 2 (Accel Ground) on pcb |  |  |  |  | V BATT | 6 |  |  | 11 | D2
7 | Centerbody Accel Signal | Blue | 24 awg |  | Wing Aft Sig | 5 |  | AC 5 | V SS | 7 |  |  | 10 | D3
8 | Centerbody Accel Gnd |  |  | Jumper to Pin 2 (Accel Ground) on pcb |  |  | Filt |  | READY | 8 |  |  | 9 | D1
 |  |  |  |  | Wing Aft Gnd | 6 |  | AC 4
General Notes: |  |  |  |  | CntB Sig | 7 |  | AC 7
 |  |  |  |  |  |  | Filt
The analog filter board has a capacitor to isolate the Accelerometer grounds; supply ground and signal ground are not equivalent |  |  |  |  | CntB Gnd | 8 |  | AC 6
Accel Ground and Signal Grounds are common (Pin 2,4,6,8)
Left wing and Aft CB Accels on one ADC, Right wing and Forward CD Accels on one ADC |  |  |  |  |  |  | * Connect V BATT to D1 with a Resistor to set I2C address to 100XX10
Separate board with 6 voltage dividers using 2x 47 Kohm Resisors for accelerometer signals, keep common pin out
 |  |  |  |  |  |  |  |  |  |  | Isolator
 |  |  |  |  |  |  |  |  |  | 1 |  |  | 1
 |  |  |  |  |  |  |  |  |  |  |  | C1 |  | C1 = 0.1 uF
 |  |  |  |  |  |  |  |  |  | 2 |  |  | 2
 |  |  |  |  |  |  |  |  |  |  | Filter
 |  |  |  |  |  |  |  |  |  | 1 | R2 |  | 1 | R2 = 47 Kohm
 |  |  |  |  |  |  |  |  |  |  |  | C2 |  | C2 = 0.22 uF
 |  |  |  |  |  |  |  |  |  | 2 |  |  | 2

Sheet: Airdata
Pressure Transducer (AMS5812) - Static
Pin | Description | Color | Type | Notes
1 | I2C SCL | white | 24 awg
2 | I2C SDA | purple | 24 awg
3 | I2C Power (5V) | green | 24 awg
4 | I2C Ground | yellow | 24 awg
Pressure Transducer (AMS5812) - Pitot
Pin | Description | Color | Type | Notes
1 | I2C SCL | white | 24 awg
2 | I2C SDA | purple | 24 awg
3 | I2C Power (5V) | green | 24 awg
4 | I2C Ground | yellow | 24 awg
General Notes:
Both Transducers can be hardwired together on a proto-board with a single connector

Sheet: 50 Pin Harness Wiring
50 PIN HARNESS
Pin | Functional Name | Color | Type | Notes
1 | MCU RESET LINE | Blue
2 | DATA DUMP GPIO | White
3 | DATA DUMP GND | Purple
4 | DATA DUMP 3.3V | White
5 | MCU RESET GND | Purple
6 | COM4 TTL RX | Red
7 | COM4 TTL TX | Blue
8 | 3.3V GPS RECEIVER PWR | Red
9 | COM0 RS232 RX | Blue
10 | COM0 RS232 TX | White
11 | GPIO - G2011AJ1_sn2497 CSPT | Purple
12 | GPIO - G2011AJ1_sn2497 CSPS | Yellow
13 | GPIO - G2011AJ1_sn2691 CSPT | Red
14 | GPIO - G2011AJ1_sn2691 CSPS | Blue
15
16 | Supply Voltage Ground | Black
17 | Supply Voltage Power | Red
18 | COM0 TTL RX | Blue
19 | COM0 TTL TX | White
20 | SPI bus #2 (CODEC CLK) | Yellow
 | COM1 RS232 GND | White
22 | GROUND | Purple
23 | 3.3V GPS RECEIVER PWR | Yellow
24 | 5V GPS ANTENNA PWR | Orange
25 | COM0 RS232 VCC | Brown
26 | COM0 RS232 GND | Black
27 | ETH_RX+ | Blue
28 | ETH_TX+ | White
29 | ETH_3.3V | Purple
30 | I2C0 CLOCK | White
31 | I2C0 DATA | Purple
32 | I2C0 GND | Yellow
33 | I2C0 5V | Green
34 | SPI bus #2 (CODEC GPIO) | Brown
35 | COM1 TTL RX | Grey
36 | COM1 TTL TX | Green
37 | COM1 TTL GND / POT GND | Orange/Blk
38 | COM1 RS232 RX | Brown
39 | COM1 RS232 TX | Black
40 | PSC6_RTS_TTL | Grey
41 | PSC6_CTS_TTL | Green
42 | 5V GPS ANTENNA PWR / POT POWER | Orange/Red
43 | SPI bus #2 (CODEC FRAME) | Black
44 | ETH_RX- | Black
45 | ETH_TX- | Grey
46 | ETH_GND | Green
47 | GPIO - G2011AJ1_sn2622 CSPT | Orange
48 | GPIO - G2011AJ1_sn2622 CSPS | Brown
49 | 6V ground
50 | 6V power
 | The 6V pwr and gnd plug goes to a male | NOTE:
 | JR Servo extension that powers the receiver

Sheet: Receiver Input Output
Receiver - AR8000 |  |  |  |  | "Input A" D-Sub Connector
Pin | Description | Color | Type | Notes | Pin | Description | Color | Type | Notes
Aux3 |  | Black, Red, Yellow | 24 awg 3 conductor | Gnd, Pwr, Signal | 1 | "Receiver Aux3" | Yellow | 24 awg, Signal line only | Auto/Manual Signal
Aux2 |  | NC, NC, Yellow | 24 awg | Signal only | 2 | "Receiver Aux1" | Yellow | Signal line only | R4 Signal
Aux1 |  | NC, NC, Yellow | 24 awg | Signal only | 3 | "Receiver Gear" | Yellow | Signal line only | L4 Signal
Gear |  | NC, NC, Yellow | 24 awg | Signal only | 4 | "Receiver Aux2" | Yellow | Signal line only | R1 Signal
Rudd |  | NC, NC, Yellow | 24 awg | Signal only | 5 | "Receiver Aile" | Yellow | Signal line only | L2/R2 Signal
Elev |  | NC, NC, Yellow | 24 awg 3 conductor | Signal only | 6 | "Receiver Rudd" | Yellow | Signal line only | L1 Signal
Aile |  | NC, NC, Yellow | 24 awg | Signal only | 7 | "Receiver Elev" | Yellow | Signal line only | L3/R3 Signal
Thro |  | NC, NC, Yellow | 24 awg | Signal only | 8 | "Receiver Thro" | Yellow | Signal line only | Throttle Signal
Bnd/Dat |  |  |  |  | 9
 |  |  |  |  | 10
 |  |  |  |  | 11
 |  |  |  |  | 12
 |  |  |  |  | 13
 |  |  |  |  | 14
 |  |  |  |  | 15
"Output" D-Sub Connector
Pin | Description | Color | Type | Notes
1 | NC |  | 24 awg
2 | R1 Signal |  | 24 awg
3 | L4 Signal |  | 24 awg
4 | R4 Signal |  | 24 awg
5 | L2/R2 Signal |  | 24 awg | Split into L2 and R2
6 | L1 Signal |  | 24 awg
7 | L3/R3 Signal |  | 24 awg | Split into L3 and R3
8 | Throttle Signal |  | 24 awg
9
10
11
12
13
14
15
General Notes:
Output D-Sub Connector - Merge Servo Signals with Pwr and Gnd
