zhaowei0566/mAEWing1/Design/FEM/FEM v5.1/NASTRAN Files/mAEWing1_FEMv5p1_Logbook.txt

FEM v5.1 is for Geri+WS4
1) Add one more node: GRID    13002           5.08      0.     0.
2) Add one more cbar element: CBAR    30051   3007    3004    13002   0.      0.      1.
3) Modify the coordinates for acceles near wing tip:GRIDS 9003-9006
4) Modify RBE2 700001-700004 
5) Some updates in CONM2_mAEWing2_updated.dat
6) Some updates in BEAM_mAEWing2_updated.dat
