zhaowei0566/mAEWing1/Software/FlightCode/aircraft/geri_config.h

#ifndef GERI_CONFIG_H_
#define GERI_CONFIG_H_

#define AIRCRAFT_GERI	///< Aircraft name. Used in daq() for sensor processing.

// Downlink telemetry configuration
#define TELEMETRY_PORT 		SERIAL_PORT3	///< Serial port for telemetry()
#define TELEMETRY_BAUDRATE	B115200			///< Baud rate of serial port for telemetry()

// Control Surface Trims
#define THROTTLE_TRIM      	0.72		///< [ND], approximate throttle trim value, 0.72
#define PITCH_SURF_TRIM   	0.0  	///< [rad], approximate elevator trim value, was -0.0872 rad
#define ROLL_SURF_TRIM    	0.0 	///< [rad], approximate aileron trim value

// Altitude Controller Theta Command limits
#define THETA_MAX 	 5.0*D2R // 
#define	THETA_MIN	 -5.0*D2R

// Control Surface limits, max and min
#define THROTTLE_MAX 	 1.0
#define	THROTTLE_MIN	 0.0
#define	L1_MAX		 0.6109	///< [rad], 35deg -- L1 Flutter Suppression Surface
#define	L1_MIN	    -0.6109 ///< [rad],-35deg -- L1 Flutter Suppression Surface
#define	L2_MAX		 0.6109	///< [rad], 35deg -- L2 Flutter Suppression Surface
#define	L2_MIN	    -0.6109 ///< [rad],-35deg -- L2 Flutter Suppression Surface
#define	L3_MAX		 0.6109	///< [rad], 35deg -- L3 Flutter Suppression Surface
#define	L3_MIN	    -0.6109 ///< [rad],-35deg -- L3 Flutter Suppression Surface
#define L4_MAX	 	 0.6109	///< [rad], 35deg -- L4 Flutter Suppression Surface
#define L4_MIN		-0.6109 ///< [rad],-35deg -- L4 Flutter Suppression Surface
#define R1_MAX	 	 0.6109	///< [rad], 35deg -- R1 Flutter Suppression Surface
#define R1_MIN		-0.6109 ///< [rad],-35deg -- R1 Flutter Suppression Surface
#define R2_MAX	 	 0.6109	///< [rad], 35deg -- R2 Flutter Suppression Surface
#define R2_MIN		-0.6109 ///< [rad],-35deg -- R2 Flutter Suppression Surface
#define R3_MAX	 	 0.6109	///< [rad], 35deg -- R3 Flutter Suppression Surface
#define R3_MIN		-0.6109 ///< [rad],-35deg -- R3 Flutter Suppression Surface
#define R4_MAX	 	 0.6109	///< [rad], 35deg -- R4 Flutter Suppression Surface
#define R4_MIN		-0.6109	///< [rad],-35deg -- R4 Flutter Suppression Surface

// MPC5200 PWM output command calibration parameters, Calibration 31June2017
#define PWMOUT_DTHR_CAL {520, 1272} ///< Calibration for throttle
#define PWMOUT_L4_CAL   { -171.72145144,	-847.33445453,	1520.85442302} ///< Calibration for L4
#define PWMOUT_L3_CAL   { -59.71310755,	-753.80091351,	1526.22387587} ///< Calibration for L3
#define PWMOUT_L2_CAL   { -58.23881363,	-763.06163025,	1523.12448423} ///< Calibration for L2
#define PWMOUT_L1_CAL   { -161.42201220,	-831.26137611,	1525.08273792} ///< Calibration for L1
#define PWMOUT_R1_CAL   { 378.30274928,	1013.47799102,	1517.32702014} ///< Calibration for R1
#define PWMOUT_R2_CAL   { 156.28340472,	800.09060307,	1517.48326854} ///< Calibration for R2
#define PWMOUT_R3_CAL   { 201.41420507,	821.63252014,	1518.57365032} ///< Calibration for R3
#define PWMOUT_R4_CAL   { 201.19953335,	829.97860205,	1522.55748568} ///< Calibration for R4

// Pilot inceptor calibration parameters
#define PITCH_INCP_CAL	{0.00130197301142324,	-3.96975198221257}	///<  linear calibration for pilot pitch inceptor
#define ROLL_INCP_CAL	{-0.00121277738367002,	3.69435537314005}	///<  linear calibration for pilot roll inceptor
#define MODE_INCP_CAL	{0.000850088662947068, -1.56545206486567} ///<  linear calibration for pilot mode inceptor
#define SELECT_INCP_CAL	{0.000863352048698032, -1.58376998680006} ///<  linear calibration for pilot select inceptor

#endif	
