zhaowei0566/mAEWing1/Software/FlightCode/extern_vars.h

/*! \file extern_vars.h
 *	\brief External variable declaration header
 *
 *	\details This file is used to declare all of the external variables
 *
 * \author University of Minnesota
 * \author Aerospace Engineering and Mechanics
 * \copyright Copyright 2011 Regents of the University of Minnesota. All rights reserved.
 *
 * $Id: extern_vars.h 761 2012-01-19 17:23:49Z murch $
 */

#ifndef EXTERN_VARS_H_
#define EXTERN_VARS_H_



#endif
