zhaowei0566/mAEWing1/(commit log)

2015-04-14 Added a sensing axis line.
    [accel - dummy.SLDPRT]
2015-04-14 Created Drawing.
    [center body.SLDASM]
2015-04-14 Moved accelerometer to be mounted on the spar skin, was on spar foam face.
    [right wing.SLDASM]
2015-04-14 Removed upper portion of winglet attach, above the spar channel. The section is too thin to be manufactured.
    [winglet attach.SLDPRT]
2015-04-15 Added Prop yoke and adapter to BOM. Added Camera details and lens extension cable. Seperated pressure sensors to callout specific static and pitot sensors, added sourcing info. Added website links to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
    [mAEWing1 - BOM.xlsx]
2015-04-16 Updated Drawings
    Added Center Body template drawing sheet to aide in cutting the spars in
    the center body.
    [center body.SLDASM, center body.SLDDRW, left inboard wing.SLDDRW, left outboard wing.SLDDRW, left wing washout.SLDDRW, left wing.SLDDRW]
2015-04-17 Fixed Rebuilt issues associated with part references and material database link. No Form/Fit/Function change in any parts.
    [Mirror - bottom back left reinforcement1.sldprt, Mirror - bottom front left reinforcement1.sldprt, Mirror - left inboard wing1.SLDPRT, Mirror - left outboard wing1.SLDPRT, Mirror - left wing washout1.SLDPRT, Mirror - top back left reinforcement1.sldprt, Mirror - top front left reinforcement1.sldprt, Part1^left wing.DXF]
2015-04-29 Created part files for mounting fixtures used for mass property testing.
    [FrontFixture.sldprt, TopFixture.sldprt, WingTipFixture.sldprt]
2015-04-29 Rebuilt following fixture creation in the top level assembly.
    [Mirror - bottom back left reinforcement1.sldprt, Mirror - bottom front left reinforcement1.sldprt, Mirror - left inboard wing1.SLDPRT, Mirror - left outboard wing1.SLDPRT, Mirror - left wing washout1.SLDPRT, Mirror - top back left reinforcement1.sldprt, Mirror - top front left reinforcement1.sldprt, center body attach.SLDPRT]
2015-05-01 BOM update. Added BECs to Flight Systems. Added fasteners for avionics and battery trays.
    [mAEWing1 - BOM.xlsx]
2015-05-04 FEM v1.1
    Updated accelerometer point masses and locations.
2015-05-12 Updated BOM to reflect actual weights. Switch to Aeronaut 12X10 Prop as baseline.
    [mAEWing1 - BOM.xlsx]
2015-05-12 Adding Wiring Guide for mAEWing1.
    [mAEWing1 - Wiring Guide.xlsx]
2015-05-19 Added additional connectors required to interface with the Goldy Flight Control System.
    [mAEWing1 - BOM.xlsx]
2015-05-19 Updating FlightCode pitch damper gain
    Updating the pitch damper gain to 0.2 from 0.7 based on prior flight
    experience.
2015-05-20 Moved Motor Mount to use the forward set of mounting holes on the "tail hard point".
    [center body.SLDASM, motor - dummy.SLDPRT, tail hard point.SLDPRT]
2015-05-20 Re-mated the pitot tube boom to reflect the as-built configuration.
    [pitot tube - dummy.SLDPRT]
2015-05-20 FlightCode for 2015-05-21
    Updated Fenrir flight code for 2015-05-21. Re-calibrated the control
    surface positions (fenrir_config.h) and validated to be within 0.5
    degrees worst case, 0.2 degrees typical. Updated the
    pitch_roll_damper.c, actuator_PWM, and daq.c to read the pilot throttle
    input, scale to the PWM output values, and send that command. This
    should have the effect of acting like a pass through on throttle to the
    pilot.
2015-05-21 Added Mobius Action Camera Model. This is a dummy part to represent the imager and lens mount.
    [MobiusCameraImager.SLDPRT]
2015-05-21 Camera Mount
    Created camera mount and added it to mAEWing1
    [Mirror - bottom back left reinforcement1.sldprt, Mirror - bottom front left reinforcement1.sldprt, Mirror - left inboard wing1.SLDPRT, Mirror - left outboard wing1.SLDPRT, Mirror - left wing washout1.SLDPRT, Mirror - top back left reinforcement1.sldprt, Mirror - top front left reinforcement1.sldprt, center body attach.SLDPRT]
2015-05-22 Updated Camera Mount
    Made minor changes to camera mount to hopefully fit better
    [flutter camera assembly.SLDASM, flutter camera mount.SLDPRT]
2015-05-22 Updated Camera Mount
    Removed clips and added a cover
    [center body.SLDASM, flutter camera assembly.SLDASM, flutter camera mount cover.SLDPRT, flutter camera mount.SLDPRT]
2015-05-25 FlightCode: Fenrir surface trims
    Adding throttle, pitch and roll trim values to Fenrir aircraft config.
    These values based on Flight 19 data. It was observed that:
    1. Throttle trim seems to be around 0.72 based on a 0 - 1 scale
    2. Elevator trim looks like it's around -6.85 degrees (i.e. 6.85 degrees
    trailing edge up).
    3. Aileron trim looks like it's around -5 degrees (5 degrees left roll)
    4. Trim airspeed is around 23 m/s
    5. Trim theta is around 7 degrees nose up
2015-05-25 FlightCode: Throttle Update
    Updated the way throttle is handled in the DAQ and actuators.c. Will
    need to update Fenrir_config.h to properly map the PWM input from the
    pilot to 0-1 and the output to 2720 - 5440 GPT. This modification was
    done to handle throttle as 0-1 throughout the code and enable airspeed
    tracking.
2015-05-26 FlightCode: Surf Cal and Limits
    Updated surface calibration and limits for all surfaces other than L1
    and R1
2015-05-26 FlightCode: Throttle Cal
    Calibrated the pilot throttle inceptor and throttle output
2015-05-28 FlightCode: Updated Roll Gains
    Updated the roll gains and anti-windup filter for attitude tracker and
    altitude / airspeed tracker.
2015-05-28 FlightCode: Manual Control
    Created a manual control law for Fenrir. This control law feeds pilot
    input to throttle, elevator (L3/R3), aileron (L2/R2), and elevon
    (L4/R4).
2015-05-28 FlightCode: Straight and Level
    Added an altitude command (h_cmd=0, hold current altitude) to the
    straight and level guidance for use with an altitude tracker.
2015-05-29 Updated Camera Mount
    [Mirror - bottom back left reinforcement1.sldprt, Mirror - bottom front left reinforcement1.sldprt, Mirror - left inboard wing1.SLDPRT, Mirror - left outboard wing1.SLDPRT, Mirror - left wing washout1.SLDPRT, Mirror - top back left reinforcement1.sldprt, Mirror - top front left reinforcement1.sldprt, center body attach.SLDPRT]
2015-05-29 Updated Camera Mount
    Made cut outs deeper and slightly wider so it will fit better.
    [flutter camera assembly.SLDASM, flutter camera mount cover.SLDPRT, flutter camera mount.SLDPRT]
2015-06-01 Updated BOM based on build of the first vehicle. Added Columns to track our inventory and ordering, these column will be removed in a future revision.
    [mAEWing1 - BOM.xlsx]
2015-06-02 FlightCode: Skoll ADCs
    Added code to read two SX8724C ADCs, poll, and log 6 channels of data
    for Skoll's wing and center body accelerometers.
2015-06-04 Sim: Throttle Limits
    Adding throttle command position limits to the mini MUTT configuration.
    Throttle is commanded as a percent between 0 and 1.
2015-06-05 FlightCode: Fenrir L4 Calibration
    Updated Fenrir's calibration for the L4 control surface. Calibration
    performed on 2015-06-05 after replacing the L4 servo.
2015-06-06 FlightCode: Ganged 3-2-1-1 OBES Pitch Surf
2015-06-09 Sim: Updated Propulsion Model
    I updated the mini MUTT geometry and propulsion model. First the
    geometry was originally defined in a coordinate system that was
    different than the body fixed frame, which was error prone. So I defined
    the c.g., aero center, and motor locations in a coordinate system
    aligned with the body fixed frame and referenced at the nose of the
    aircraft. Second, There was an error in the way the motor alignment was
    defined (originally, this was put in as a yaw alignment, when it was
    meant as a pitch alignment). Finally, I updated the locations and
    alignments wrt data CR sent based on the SolidWorks model and validated
    the forces and moments in the NL and SIL simulations.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
2015-06-10 FlightCode: Updated Fenrir Cal
    Updated the Fenrir PWM output calibration for L4 and R4 following
    replacing the servos.
2015-06-10 FlightCode: Attitude Tracking
    Created a new mission manager three position switch to change between
    three different control laws while in autopilot mode. Created an
    attitude tracking control law where mode 0 allows the pilot to command
    phi and theta while controlling throttle directly. Mode 1 allows the
    pilot to command phi and theta with an autothrottle running. Updated the
    global defs and datalogging to support these new features.
2015-06-10 FlightCode: Z dot controller
    Created a new controller to enable z dot tracking and autolanding. Mode
    0 enables the pilot to command theta and phi with an autothrottle
    running. Mode 1 is meant for an initial approach, with a z dot tracker
    running and autothrottle running, but the pilot commanding phi. Mode 2
    is meant for short final / flare, with a z dot tracker running with a
    lower reference command than the approach, an autothrottle running, and
    a wing leveler running.
2015-06-12 Final Camera Mount
    [Mirror - bottom back left reinforcement1.sldprt, Mirror - bottom front left reinforcement1.sldprt, Mirror - left inboard wing1.SLDPRT, Mirror - left outboard wing1.SLDPRT, Mirror - left wing washout1.SLDPRT, Mirror - top back left reinforcement1.sldprt, Mirror - top front left reinforcement1.sldprt, center body attach.SLDPRT]
2015-06-12 FlightCode: Update from Fenrir Flight 28
    The as flown control laws for Fenrir flight 28, gains and trim values
    modified slightly from data analysis of flights 26 and 27.
2015-06-12 FlightCode: Adding Skoll and Hati
    Adding gains and trim pitch angles to our main control laws used for
    PAAW mAEWing1 research flights.
2015-06-12 FlightCode: Skoll Datalog Zdot
    Adding z dot command and claw mode to Skoll's datalogging to support
    tres claw.
2015-06-12 FlightCode: Skoll Surface Limits
    Moving Skoll's surface limits out to +/-35 degrees. We may have to
    update these after the surface calibration.
2015-06-17 updated SIL autoland routine to resemble current flights
2015-06-17 updated autoland control to resemble current flight tests
2015-06-22 Voltage Divider and ADC Connector
    Added note to include voltage divider on accelerometer signals. Flipped
    the drawing of the "ADC Connector". Updated Receiver/Input/Output
    harnesses.
    [mAEWing1 - Wiring Guide.xlsx]
2015-06-22 Servo Reverser and Voltage Divider
    Added Flight Systems Part for Servo Reverser. Added Parts for
    accelerometer voltage divider.
    [mAEWing1 - BOM.xlsx]
2015-06-27 Added Mass Properties spreadsheet
    Added Excel based spreadsheet providing mass property test results. Mass
    property updates are provided on the tracking tab.
    [mAEWing1 - Mass Properties.xlsx]
2015-07-01 Updated Propulsion Battery
    Updated Propulsion Battery to the 2x TP3300. Added an alternate servo
    arm that will be used on the second build. Added columns to specify the
    location of component in the centerbody.
    [mAEWing1 - BOM.xlsx]
2015-07-01 Added Configuration Tracking Sheet
    Added Excel spreadsheet to track configuration, changes, and repairs.
    The Mass Property sheet also tracks changes that effect mass properties.
    [mAEWing1 - Configuration Tracking.xlsx]
2015-07-01 Updated Mass Properties following Flight 2
    update included repair mass and updated ballast based on component
    weighing and longitudinal CG balance.
    [mAEWing1 - Mass Properties.xlsx]
2015-07-01 FlightCode: Updated L1 / R1 Calibration
    Updated Skoll's calibration for L1 and R1 control surfaces.
2015-07-06 FlightCode: Throttle Cut in Manual Mode
    Removed the high gain theta doublet experiment and added a throttle cut
    in pilot stick -> theta and phi cmd as a backup for landing.
2015-07-06 Revert "FlightCode: Throttle Cut in Manual Mode"
    This reverts commit 48033d1c084d7ef18592ed25b3eadc4fad52d908.
    [main.c]
2015-07-07 Updated Configuration log following Flight03
    Detailed repairs and component swaps following damage from Flight03.
    [mAEWing1 - Configuration Tracking.xlsx]
2015-07-14 Updated to Solidworks 2015
    Updated parts, assemblies, and drawings to Solidworks 2015.
    [FrontFixture.sldprt, Mirror - bottom back left reinforcement1.sldprt, Mirror - bottom front left reinforcement1.sldprt, Mirror - left inboard wing1.SLDPRT, Mirror - left outboard wing1.SLDPRT, Mirror - left wing washout1.SLDPRT, Mirror - top back left reinforcement1.sldprt, Mirror - top front left reinforcement1.sldprt]
2015-07-14 Moved Body Flap
    Moved Body Flaps aft 1/8 inch
    [mAEWing1.SLDASM]
2015-07-14 Added Avionics Cover
    Added the Avionics Cover to the Centerbody Assembly.
    [AvionicsCover.sldprt, center body attach.SLDPRT, center body.SLDASM, inboard rib keel attachment.SLDPRT, inboard rib.SLDPRT, mAEWing1.SLDASM]
2015-07-18 Added Wing Tip Accelerometer brackets
    Created a forward and aft wing tip accelerometer standoffs to move the
    accels further apart.
    [AccelBracketLeftAft.sldprt, AccelBracketLeftFwd.sldprt, Mirror - left outboard wing1.SLDPRT, Mirror - left wing.SLDASM, left wing.SLDASM, left wing.SLDDRW, mAEWing1.SLDASM, mAEWing1.SLDDRW]
2015-07-29 FlightCode: MPC5200 SpeedUp
    Code required for Goldy speedup (Goldy 1.5). Now runs at 100 Hz.
2015-07-29 FlightCode: A/S Low Pass Filter
    Updating the airspeed low pass filter for running at 100 Hz.
2015-07-29 FlightCode: Accel Calibration
    Adding calibration scale factors and bias for the accelerometers.
2015-07-29 FlightCode: Mode and Select Switches
    Renamed the Yaw and Throttle inceptors to reflect their current use as
    "mode" and "select" switches for selecting control laws.
2015-07-29 FlightCode: Asynchronous cortex
    Removed the low pass filters from the analog read portion of the Cortex
    software and made the "sensor" operate in asynchronous mode (i.e. only
    gathers and sends data when requested from Goldy).
2015-07-29 FlightCode: PWM Calibration
    Updated the PWM input calibration: pitch and roll stick are scaled to -1
    to 1 and mode / select switches are scaled 0 to 2. Updated the mission
    logic for the new switch calibration and the pilot guidance for the new
    pitch and roll scaling.
2015-07-29 Added Flutter Suppression (100Hz Sampling Rate) Added Chirp Signal sysid_pitch_chirps.c Adjusted SIL to deal with new folder structure
2015-07-30 FlightCode: GPS Handling
    Updated rabbit so that GPS bytes are read in the correct order. Also
    updated daq so that GPS update starts occurring 20 sec after GPS lock on
    at least 5 satellites and fixed the vd calculation by grabbing the time
    difference between gps updates.
    [daq.c, globaldefs.h, rabbit.c]
2015-07-30 FlightCode: accel update
    Updated the rabbit to poll accel data at 1000 Hz, filter to 50 Hz, and
    send the filtered data to the Goldy FCS to remove aliasing. Updated the
    Goldy FCS accel calibrations to account for caps put on an analog filter
    on the accel channels.
2015-07-31 FlightCode: IMU Digital Filter
    Modifying the IMU digital filter for a 50 Hz cutoff frequency instead of
    16 Hz.
2015-07-31 FlightCode: Updated Sys ID and CLAW
    Updated sys id for the upcoming flight. 3 seconds waiting, then a
    3-2-1-1 on surf pair 3, 8 seconds later a 3-2-1-1 on surf pair 4 and
    repeat. Added a timer on the experimental mode to switch between flutter
    supp on to off after 20 seconds into the experiment so we get both sets
    of data. Added a timer to automate the throttle cutoff after speed drops
    below 8 m/s in flare mode.
2015-08-03 Mirror Left Wing to Right Wing
    Mirror to populate the accel brackets from the left wing to the right
    wing.
    [AccelBracketLeftAft - Mirror.sldprt, AccelBracketLeftAft.sldprt, AccelBracketLeftFwd - Mirror.sldprt, AccelBracketLeftFwd.sldprt, accel - dummy - Mirror.SLDPRT, bottom back left reinforcement - Mirror.sldprt, bottom front left reinforcement - Mirror.sldprt, control surface - Mirror.sldprt]
2015-08-03 Mass Property and Configuration Update
    Captures Goldy upgrade
    [mAEWing1 - Configuration Tracking.xlsx, mAEWing1 - Mass Properties.xlsx]
2015-08-05 FlightCode: Updated CLAW Switching and Sys ID
    Updated the CLAW switching to improve readability. Prepped the flight
    software for Skoll Flight 06. Planned: Chirps on surf pair 3/4 open
    loop, 3-2-1-1 on surf pair 3/4 open loop, theta and phi doublets on
    updated closed loop claw.
2015-08-06 Mass Property Cleanup
    Removed Raw test data from the Mass Properties Tracking Spreadsheet.
    [mAEWing1 - Mass Properties.xlsx]
2015-08-07 FlightCode: Debug CLAW and Updated Cal
    Debugged the control laws for Flight 06 and validated on the aircraft.
    Updated the surface calibration for L4, after replacing the servo.
2015-08-11 Adjusted Chirp Excitation to be scaled with dynamic pressure for larger velocity run
2015-08-11 Flight Code: Updated Skoll Calibration
    Updated Skoll calibration for all servos other than L1.
2015-08-12 Configuration Updates following Skoll Flight 6
    Configuration and Mass Property Update following flight 6. These are
    applicable for flight 7, 8, and 9.
    [mAEWing1 - Configuration Tracking.xlsx, mAEWing1 - Mass Properties.xlsx]
2015-08-12 FlightCode: Telemetry Scheduling
    Increased the rate of telemetry to 100 Hz from 25 Hz to remove a 25 Hz
    mode that was showing up on pressure inducers and accels. Validated that
    increasing the TM frequency doesn't seem to have an adverse affect on
    the GCS and does remove these modes.
    [scheduling.h]
2015-08-13 Chirp excitation signals for upcoming sys ID flight
    1. run @23m/s 15 seconds sweep 0.5-8.5 flap3 followed by 15 seconds sweep 0.5-8.5 flap4
    2. run @23m/s 17 seconds sweep 0.5-8.5 flap3
    3. run @27m/s 17 seconds sweep 0.5-8.5 flap4
    Amplitudes for larger speed are scaled by dynamic pressure and time to build up airspeed has been incorporated
2015-08-13 FlightCode: Updated Final Frequencies and Flight 11 Prep
    Updated the final frequencies for Flight 10 to fully capture the 8.5 Hz
    and prepped a control law and sys id file for flight 11.
2015-08-14 FlightCode: Debugged Flight 10 and 11
    Debugged the flight 10 and 11 software. The only bug encountered was
    computing the completion status to send to the GCS (mis-called the
    control data pointer).
    [main.c]
2015-08-25 FlightCode: Flight 10 and 11
    Updated calibration for Skoll after replacing all of the left wing
    actuators and R1. Also set the pitch damper to zero in the closed loop
    control law instead of -0.01.
2015-09-02 Corrected Skoll, Added Hati
    Corrected improperly indexed fixture values in the Skoll data set. Added
    Hati datasets and tracking sheet based on tests conducted on 8/31/2015.
    [mAEWing1 - Mass Properties.xlsx]
2015-09-02 Removed Skoll, added Hati
    Skoll is no longer in configuration control. Hati is now in
    configuration control. WS3 fabrication has started.
    [mAEWing1 - Configuration Tracking.xlsx]
2015-09-03 Mass Properties update to denote flights
    I added some of the flight numbers to the spreadsheet tracking Skoll's
    mass properties.
    [mAEWing1 - Mass Properties.xlsx]
2015-09-18 FlightCode: SpeedUp
    Included mission etime in datalog. Changed scheduling to run at 150 Hz
    frame rate with the actuator alarm at 5.5 ms. Synced M4 DAQ to Goldy 1.5
    frame and wrote a better pwm generator at 333 Hz.
2015-09-29 Updated Config and Mass Tracking
    Hati with WS2 and WS3 are under configuration control. Still need Servo
    serial numbers added to the configuration of WS3.
    [mAEWing1 - Configuration Tracking.xlsx, mAEWing1 - Mass Properties.xlsx]
2015-09-30 FlightCode: Hati
    Added Hati config with surface calibrations. Also added a Hati datalog
    and put hooks in tres_claw to look for the Hati aircraft. Still need to
    calibrate the inceptor channels for Hati.
2015-10-01 FlightCode: Hati Config Inceptor Calibration
    Updated the inceptor calibration for Hati.
2015-10-02 FlightCode: Hati Prelim Software Build Flight 1-3
    Preliminary software build for Hati flights 1-3. Still need to calibrate
    accelerometers.
2015-10-09 Software: Jack Rabbit
    Updating the JackRabbit code to lower the PWM update rate for the
    throttle channel. Also made a minor change to the control surface PWM,
    which should improve accuracy.
2015-10-12 Jack Rabbit: R4 PWM Channel, Throttle Update, GPS
    Updated the throttle pwm refresh rate to 50 Hz, which also meant moving
    the R4 to channel 10 instead of 23 (since that timer was shared with the
    throttle timer). To free up channel 10, GPS was moved onto the hardware
    serial instead of the soft serial.
2015-10-13 FlightCode: Updated TFTP Transfer
    Updated the code that transfers the flight data from Goldy to the flight
    laptop. This code now will continue to try to transfer the data until
    the transfer is successful. This capability has been validated on the
    ground with no issues transferring the flight data.
2015-10-13 FlightCode: Memory Protection
    The flight computers memory is limited to about 90000 data samples,
    which was 30 minutes at the old rate of 50 Hz. Running at 150 Hz means
    that this is now 10 minutes. In order to prevent flight data corruption
    or loss, there is now protection where the system stops writing flight
    data after 80000 samples (about 8 minutes). Operationally, this means
    less of a rush getting to the aircraft and getting the data offloaded,
    we'll just need to be careful to start the flight within ~3 minutes of
    loading software.
    [main.c]
2015-10-13 FlightCode: Hati + WS2 Accel Cal
    Updated the daq for the Hati and WS 2 accel calibration.
2015-10-22 Tailboom to 0.530
    The first set of cut parts were slightly loose on the tailboom. Changed
    0.55" to 0.53"
    [mAEWing1 - Configuration Tracking.xlsx]
2015-11-03 FlightCode: Nav Init
    Modified the EKF initialization such that the accelerometers are used to
    initialize the pitch and roll angles. Currently, the heading angle is
    set to a West initialization and will need to be changed at the field
    depending on operations.
2015-11-04 FlightCode: Datalog trigger
    Added a trigger to start the data logging. Now the datalog will start
    after the pilot switches into autopilot for the first time. This means
    for a flight op, shortly before flight, the pilot should switch into and
    out of the autopilot mode to begin the datalog. After the initial
    trigger, the log stays on until the memory protection kicks in about 8
    minutes later. The upper left GCS light was used to illuminate when
    logging starts.
    [globaldefs.h, main.c]
2015-11-04 FlightCode: EKF
    While testing the datalogging, the nav filter kept tumbling, so I'm
    putting the nav filter initialization back to the way it was. More
    testing is needed. In the mean time, turn on the aircraft pointing east
    and move around some before launch.
2015-11-04 FlightCode: GPS
    Updating the GPS data collection in Jack Rabbit to accomplish two
    things: 1. the GPS data should now have higher precision. Whether this
    impacts the navigation filter remains to be seen, but the precision
    should now be equal to the precision carried within the rest of the
    software. 2. Validity of GPS data is checked before assigning to
    variables. Occasionally we've seen some weird behavior with GPS that
    obviously outran the data type the data was being stored in. I believe
    this may have been some invalid GPS data getting into the system. The
    additional checks should hopefully prevent this from occurring going
    forward.
    [rabbit.c]
2015-11-04 FlightCode: Nav Filter Init
    Modified the nav filter init to improve filter convergence. Pitch and
    roll angle are initialized based on the accelerometer measurements (the
    aircraft will need to be stationary during init, but this was always the
    case due to grabbing sensor bias at that time). Heading is initialized
    based off the magnetometer readings.
2015-11-10 Removing CAD folder in prep for Git LFS
2015-11-13 Added GVT Data for WS3;wings only
2015-11-18 CAD Model coloring
    Adjusted the colors etc. on the CAD model.
    [mAEWing1.SLDASM, mAEWing1.SLDDRW, right wing.SLDASM]
2015-11-20 FlightCode: Removing old versions of M4 Software
    Removing old versions of the teensy 3.1 software
2015-12-08 FlightCode: Datalog Bug Fix
    Fixed a bug in datalog - the loop counter was moved in the code to
    implement the trigger to begin recording. This move accidentally
    introduced a bug where the data log loop counter, which is used to
    protect the memory from over running, only ran in auto mode. This update
    moves the loop counter and has been validated to fix this bug.
    [globaldefs.h, main.c]
2015-12-08 Flight Code: Throttle Mapping
    Instead of auto endpoint detection on the ESC, we moved to fixed
    endpoints, which were set using the DX9 transmitter. These endpoints
    were set to PWM values of 1272 and 1792. The hati config was changed so
    that the 0-1 throttle command will map now to 1272 and 1792 PWM values
    instead of the 1000 to 2000 values used previously.
    [hati_config.h]
2016-02-12 FEM updates NASTRAN Sol200 files
    Three NASTRAN Sol200 inputs files for centerbody, wing and the full
    model
2016-04-19 FlightCode: Bug Fix Autothrottle
    Fixed a bug in the autothrottle for "pilot flying" mode that resulted in
    erratic commands being sent to the esc.
2016-04-28 BOM Update for new linkages
    [mAEWing1 - BOM.xlsx, mAEWing1.SLDASM, mAEWing1.SLDDRW, right wing.SLDASM]
2016-05-10 FEM V4.2.1 for Hati+WS3
    The accelerometers locations in the WS3 are updated.
2016-05-16 Updated Hati Surface Calibrations
    Re-calibrated Hati control surfaces on 5/16/16
2016-05-26 FEM v4.2.1
    Update wing tip accelerometers locations for WS3.
2016-05-26 FEM v4.2.1
    Update wing tip acclerometers locations based on FEM v4.2
2016-07-22 Updated Telemetry for GCS Flags
    Changed the Flag setting in the GCS. Displays Auto mode, CLAW mode, and
    CLAW select.
2016-07-22 Fixed labels in globaldefs.h
    [globaldefs.h]
2016-08-08 Updated Config and Mass tracking
    [mAEWing1 - Configuration Tracking.xlsx, mAEWing1 - Mass Properties.xlsx]
2016-08-08 Debug serial prints
2016-08-10 Added Altitute Hold mode for excitations.
    Added altitude hold mode as an addative controller with the theta
    tracker. Removed integrator reset that was prior to the controller
    switch for excitations. Removed pitch derivative gain. Tweaked the
    telemetry to increase the altitude resolution.
    [daq.c, geri_config.h, globaldefs.h]
2016-08-11 Added overspeed cutoff for Sysid
    Sysid excitation is only applied if the airspeed tracking error is below
    the theshold. Threshold is set at 2 m/s.
    [daq.c]
2016-08-11 Control Surface Calibration
    Surface calibrations for Geri.
2016-08-15 Fixed sign of surface cal
    Surface Cal tables had incorrect sign, fixed. Tested.
    [geri_config.h]
2016-09-09 Fixed Single surface pitch gains
2016-09-27 Flight Software build for FLT04 and FLT05
    Changed the trim pitch surface offset to zero. reduced the theta command
    offset to 2.0 degrees. Both are the reduce the transient and better
    match the observed flight trim from FLT02.
2016-10-04 Update Config Tracking and Mass Properties Tracking
    Updated for Motor swap following abort prior to FLT05. Replaced GPS with
    Ublox M8N.
    [mAEWing1 - Configuration Tracking.xlsx, mAEWing1 - Mass Properties.xlsx]
2016-10-12 Changed GPS Message in Teensy for Ublox M8N
    Modified a few of the fields in the ublox message. The Ublox 7 and 8
    nav-pvt message is slightly different.
2016-10-19 Next candidate FLT05 and FLT06 flight code
    There is an issue with FLT CLAW during the decel, accel that needs to be
    fixed.
2016-11-01 Geri FLT06 Flight Code
    [mAEWing1 - Mass Properties.xlsx]
2017-06-28 Added Calibration Code
2017-06-28 Updated Surface Calibration
2017-06-28 Revision to FLT15 and FLT16
    Updated code and recompiled with new surface calibrations.
